johonkanen/agilex3_control_card/reference/bom_draft.csv

ref | value | footprint | lcsc | mpn | dnp
C1 | 10u | Capacitor_SMD:C_0603_1608Metric | C19702 | CL10A106KP8NNNC | False
C2 | 22u | Capacitor_SMD:C_0603_1608Metric | C59461 | CL10A226MQ8NRNC | False
C3 | 22u | Capacitor_SMD:C_0603_1608Metric | C59461 | CL10A226MQ8NRNC | False
C4 | 22p | Capacitor_SMD:C_0402_1005Metric | C1555 | 0402CG220J500NT | False
C5 | 10u | Capacitor_SMD:C_0603_1608Metric | C19702 | CL10A106KP8NNNC | False
C6 | 22u | Capacitor_SMD:C_0603_1608Metric | C59461 | CL10A226MQ8NRNC | False
C7 | 22p | Capacitor_SMD:C_0402_1005Metric | C1555 | 0402CG220J500NT | False
C8 | 10u | Capacitor_SMD:C_0603_1608Metric | C19702 | CL10A106KP8NNNC | False
C9 | 22u | Capacitor_SMD:C_0603_1608Metric | C59461 | CL10A226MQ8NRNC | False
C10 | 1u | Capacitor_SMD:C_0402_1005Metric | C52923 | CL05A105KA5NQNC | False
C11 | 4u7 | Capacitor_SMD:C_0603_1608Metric | C19666 | CL10A475KO8NNNC | False
C12 | 1u | Capacitor_SMD:C_0402_1005Metric | C52923 | CL05A105KA5NQNC | False
C13 | 1u | Capacitor_SMD:C_0402_1005Metric | C52923 | CL05A105KA5NQNC | False
C14 | 22u | Capacitor_SMD:C_0805_2012Metric | C45783 | CL21A226MAQNNNE | False
C15 | 22u | Capacitor_SMD:C_0805_2012Metric | C45783 | CL21A226MAQNNNE | False
C16 | 100n | Capacitor_SMD:C_0402_1005Metric | C1525 | CL05B104KO5NNNC | False
C17 | 22u | Capacitor_SMD:C_0603_1608Metric | C59461 | CL10A226MQ8NRNC | False
C18 | 22u | Capacitor_SMD:C_0603_1608Metric | C59461 | CL10A226MQ8NRNC | False
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
C72 | 1u | Capacitor_SMD:C_0201_0603Metric | C170152 | CL03A105MQ3CSNC | False
C73 | 1u | Capacitor_SMD:C_0201_0603Metric | C170152 | CL03A105MQ3CSNC | False
C74 | 1u | Capacitor_SMD:C_0402_1005Metric | C52923 | CL05A105KA5NQNC | False
C75 | 4u7 | Capacitor_SMD:C_0603_1608Metric | C19666 | CL10A475KO8NNNC | False
C76 | 1u | Capacitor_SMD:C_0201_0603Metric | C170152 | CL03A105MQ3CSNC | False
D1 | RGB | control_card:LED_RGB_APFA3010_RightAngle | C5393554 | APFA3010LSEEZGKQBKC | False
D2 | RGB | control_card:LED_RGB_APFA3010_RightAngle | C5393554 | APFA3010LSEEZGKQBKC | False
FB1 | 120R@100MHz | Inductor_SMD:L_0603_1608Metric | C14709 | BLM18PG121SN1D | False
FB2 | 120R@100MHz | Inductor_SMD:L_0603_1608Metric | C14709 | BLM18PG121SN1D | False
FB3 | 120R@100MHz | Inductor_SMD:L_0603_1608Metric | C14709 | BLM18PG121SN1D | False
FB4 | 120R@100MHz | Inductor_SMD:L_0603_1608Metric | C14709 | BLM18PG121SN1D | False
FB5 | 120R@100MHz | Inductor_SMD:L_0603_1608Metric | C14709 | BLM18PG121SN1D | False
J1 | Power board | control_card:PinHeader_2x25_P1.27mm_Horizontal_U25 |  |  | False
J2 | JTAG | Connector_PinHeader_2.54mm:PinHeader_1x05_P2.54mm_Vertical |  |  | False
L1 | 1u | Inductor_SMD:L_Cenker_CKCS201610 | C97002 | WPN201610H1R0MT | False
L2 | 1u | Inductor_SMD:L_Cenker_CKCS201610 | C97002 | WPN201610H1R0MT | False
L3 | 1u | Inductor_SMD:L_Cenker_CKCS201610 | C97002 | WPN201610H1R0MT | False
R1 | 49k9 | Resistor_SMD:R_0402_1005Metric | C25897 | 0402WGF4992TCE | False
R2 | 200k | Resistor_SMD:R_0402_1005Metric | C25764 | 0402WGF2003TCE | False
R3 | 100R | Resistor_SMD:R_0402_1005Metric | C25076 | 0402WGF1000TCE | False
R4 | 10R | Resistor_SMD:R_0402_1005Metric | C25077 | 0402WGF100JTCE | False
R5 | 100k | Resistor_SMD:R_0402_1005Metric | C25741 | 0402WGF1003TCE | False
R6 | 200k | Resistor_SMD:R_0402_1005Metric | C25764 | 0402WGF2003TCE | False
R7 | 100k | Resistor_SMD:R_0402_1005Metric | C25741 | 0402WGF1003TCE | False
R8 | 100k | Resistor_SMD:R_0402_1005Metric | C25741 | 0402WGF1003TCE | False
R9 | 200k | Resistor_SMD:R_0402_1005Metric | C25764 | 0402WGF2003TCE | False
R10 | 44k2 | Resistor_SMD:R_0402_1005Metric | C25895 | 0402WGF4422TCE | False
R11 | 4k7 | Resistor_SMD:R_0402_1005Metric | C25900 | 0402WGF4701TCE | False
R12 | 4k7 | Resistor_SMD:R_0402_1005Metric | C25900 | 0402WGF4701TCE | False
R13 | 4k7 | Resistor_SMD:R_0402_1005Metric | C25900 | 0402WGF4701TCE | False
R14 | 4k7 | Resistor_SMD:R_0402_1005Metric | C25900 | 0402WGF4701TCE | True
R15 | 10k | Resistor_SMD:R_0402_1005Metric | C25744 | 0402WGF1002TCE | False
R16 | 10k | Resistor_SMD:R_0402_1005Metric | C25744 | 0402WGF1002TCE | False
R17 | 10k | Resistor_SMD:R_0402_1005Metric | C25744 | 0402WGF1002TCE | False
R18 | 10k | Resistor_SMD:R_0402_1005Metric | C25744 | 0402WGF1002TCE | False
R19 | 2k | Resistor_SMD:R_0402_1005Metric | C4109 | 0402WGF2001TCE | False
R20 | 1k | Resistor_SMD:R_0201_0603Metric | C270365 | 0201WMF1001TEE | False
R21 | 10k | Resistor_SMD:R_0201_0603Metric | C473048 | 0201WMF1002TEE | False
R22 | 10k | Resistor_SMD:R_0201_0603Metric | C473048 | 0201WMF1002TEE | False
R23 | 10k | Resistor_SMD:R_0201_0603Metric | C473048 | 0201WMF1002TEE | False
R24 | 10k | Resistor_SMD:R_0402_1005Metric | C25744 | 0402WGF1002TCE | False
R25 | 33R | Resistor_SMD:R_0402_1005Metric | C25105 | 0402WGF330JTCE | False
R26 | 33R | Resistor_SMD:R_0402_1005Metric | C25105 | 0402WGF330JTCE | False
R27 | 33R | Resistor_SMD:R_0402_1005Metric | C25105 | 0402WGF330JTCE | False
R28 | 33R | Resistor_SMD:R_0402_1005Metric | C25105 | 0402WGF330JTCE | False
R29 | 33R | Resistor_SMD:R_0402_1005Metric | C25105 | 0402WGF330JTCE | False
R30 | 33R | Resistor_SMD:R_0402_1005Metric | C25105 | 0402WGF330JTCE | False
R31 | 33R | Resistor_SMD:R_0402_1005Metric | C25105 | 0402WGF330JTCE | False
R32 | 33R | Resistor_SMD:R_0402_1005Metric | C25105 | 0402WGF330JTCE | False
R33 | 33R | Resistor_SMD:R_0402_1005Metric | C25105 | 0402WGF330JTCE | False
R34 | 100R | Resistor_SMD:R_0402_1005Metric | C25076 | 0402WGF1000TCE | False
R35 | 100R | Resistor_SMD:R_0402_1005Metric | C25076 | 0402WGF1000TCE | False
R36 | 100R | Resistor_SMD:R_0402_1005Metric | C25076 | 0402WGF1000TCE | False
R37 | 100R | Resistor_SMD:R_0402_1005Metric | C25076 | 0402WGF1000TCE | False
R38 | 100R | Resistor_SMD:R_0402_1005Metric | C25076 | 0402WGF1000TCE | False
R39 | 100R | Resistor_SMD:R_0402_1005Metric | C25076 | 0402WGF1000TCE | False
U1 | A3CZ065BB18AE7S | control_card:Altera_B18A |  | A3CZ065BB18AE7S | False
U2 | AP61302Z6-7 | Package_TO_SOT_SMD:SOT-563 | C3193204 | AP61302Z6-7 | False
U3 | AP61102Z6-7 | Package_TO_SOT_SMD:SOT-563 | C5224055 | AP61102Z6-7 | False
U4 | AP61102Z6-7 | Package_TO_SOT_SMD:SOT-563 | C5224055 | AP61102Z6-7 | False
U5 | TLV75512PDBVR | Package_TO_SOT_SMD:SOT-23-5 | C2877864 | TLV75512PDBVR | False
U6 | TLV75533PDBVR | Package_TO_SOT_SMD:SOT-23-5 | C404027 | TLV75533PDBVR | False
U7 | MT25QU256ABA8E12-1SIT | control_card:BGA-24_6x8mm_Layout5x5_P1.0mm_CY0.5 | C2061023 | MT25QU256ABA8E12-1SIT | False
U8 | SN74AVC4T774RSVR | Package_DFN_QFN:UQFN-16_1.8x2.6mm_P0.4mm | C779392 | SN74AVC4T774RSVR | False
U9 | W958D8NBYA5I | control_card:BGA-24_6x8mm_Layout5x5_P1.0mm_CY0.5 | C7420405 | W958D8NBYA5I | False
U10 | SN74LV4051APWR | Package_SO:TSSOP-16_4.4x5mm_P0.65mm | C7793 | SN74LV4051APWR | False
U11 | OPA365AIDBVR | Package_TO_SOT_SMD:SOT-23-5 | C96626 | OPA365AIDBVR | False
U12 | ADS7056IRUGR | Package_DFN_QFN:Texas_UQFN-8_1.5x1.5mm_P0.5mm | C2669798 | ADS7056IRUGR | False
U13 | SN74LV4051APWR | Package_SO:TSSOP-16_4.4x5mm_P0.65mm | C7793 | SN74LV4051APWR | False
U14 | OPA365AIDBVR | Package_TO_SOT_SMD:SOT-23-5 | C96626 | OPA365AIDBVR | False
U15 | ADS7056IRUGR | Package_DFN_QFN:Texas_UQFN-8_1.5x1.5mm_P0.5mm | C2669798 | ADS7056IRUGR | False
U16 | TLV75518PDBVR | Package_TO_SOT_SMD:SOT-23-5 | C2877863 | TLV75518PDBVR | False
X1 | 100MHz | Oscillator:Oscillator_SMD_Abracon_ASE-4Pin_3.2x2.5mm | C4353707 | OT3225100MJBA4SL | False
