johonkanen/agilex3_control_card/hardware/control_card.kicad_pcb

## KiCad design hardware/control_card.kicad_pcb (2026-10-28)

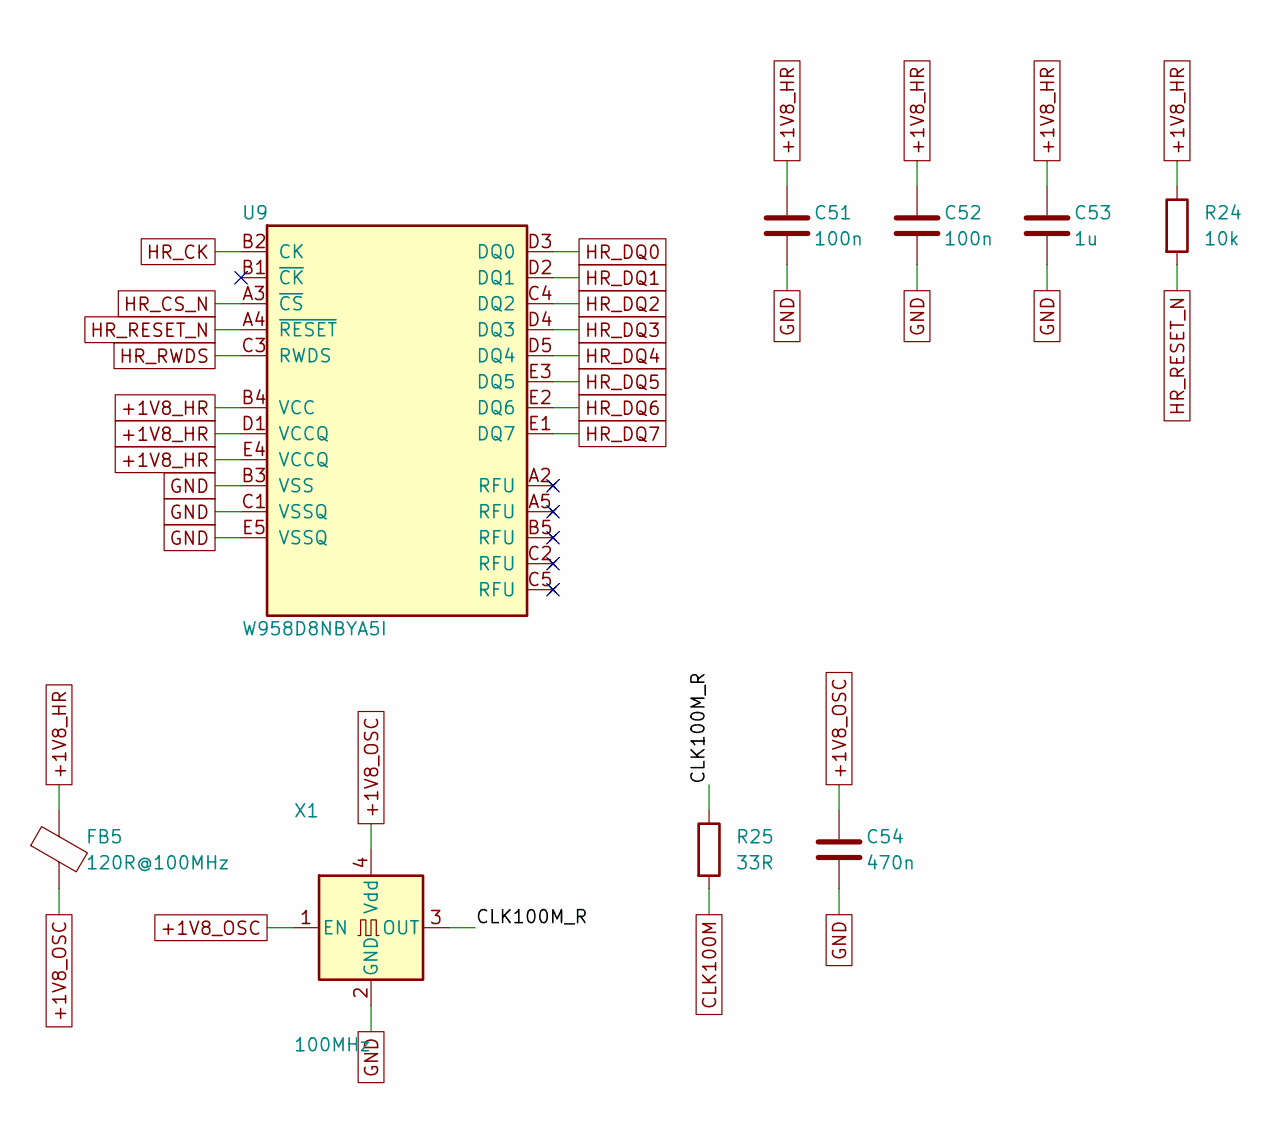
[picture p3: schematic memory.kicad_sch, HyperRAM (1.8 V) and 100 MHz oscillator]

Parts:
C51, C52: 100n; C_0402_1005Metric; MPN CL05B104KO5NNNC; LCSC C1525
C53: 1u; C_0402_1005Metric; MPN CL05A105KA5NQNC; LCSC C52923
C54: 470n; C_0402_1005Metric; MPN CL05A474KP5NNNC; LCSC C47339
FB5: 120R@100MHz; L_0603_1608Metric; MPN BLM18PG121SN1D; LCSC C14709
R24: 10k; R_0402_1005Metric; MPN 0402WGF1002TCE; LCSC C25744
R25: 33R; R_0402_1005Metric; MPN 0402WGF330JTCE; LCSC C25105
U9: W958D8NBYA5I; BGA-24_6x8mm_Layout5x5_P1.0mm_CY0.5; MPN W958D8NBYA5I; LCSC C7420405
X1: 100MHz; Oscillator_SMD_Abracon_ASE-4Pin_3.2x2.5mm; MPN OT3225100MJBA4SL; LCSC C4353707

Connections:
+1V8_HR: C51.1, C52.1, C53.1, FB5.1, R24.1, U9.B4 (VCC), U9.D1 (VCCQ), U9.E4 (VCCQ); also elsewhere on the board
+1V8_OSC: C54.1, FB5.2, X1.1 (EN), X1.4 (Vdd)
/HyperRAM and clock/CLK100M_R: R25.1, X1.3 (OUT)
CLK100M: R25.2; also elsewhere on the board
GND: C51.2, C52.2, C53.2, C54.2, U9.B3 (VSS), U9.C1 (VSSQ), U9.E5 (VSSQ), X1.2 (GND); also elsewhere on the board
HR_CK: U9.B2 (CK); also elsewhere on the board
HR_CS_N: U9.A3 (~CS); also elsewhere on the board
HR_DQ0: U9.D3 (DQ0); also elsewhere on the board
HR_DQ1: U9.D2 (DQ1); also elsewhere on the board
HR_DQ2: U9.C4 (DQ2); also elsewhere on the board
HR_DQ3: U9.D4 (DQ3); also elsewhere on the board
HR_DQ4: U9.D5 (DQ4); also elsewhere on the board
HR_DQ5: U9.E3 (DQ5); also elsewhere on the board
HR_DQ6: U9.E2 (DQ6); also elsewhere on the board
HR_DQ7: U9.E1 (DQ7); also elsewhere on the board
HR_RESET_N: R24.2, U9.A4 (~RESET); also elsewhere on the board
HR_RWDS: U9.C3 (RWDS); also elsewhere on the board

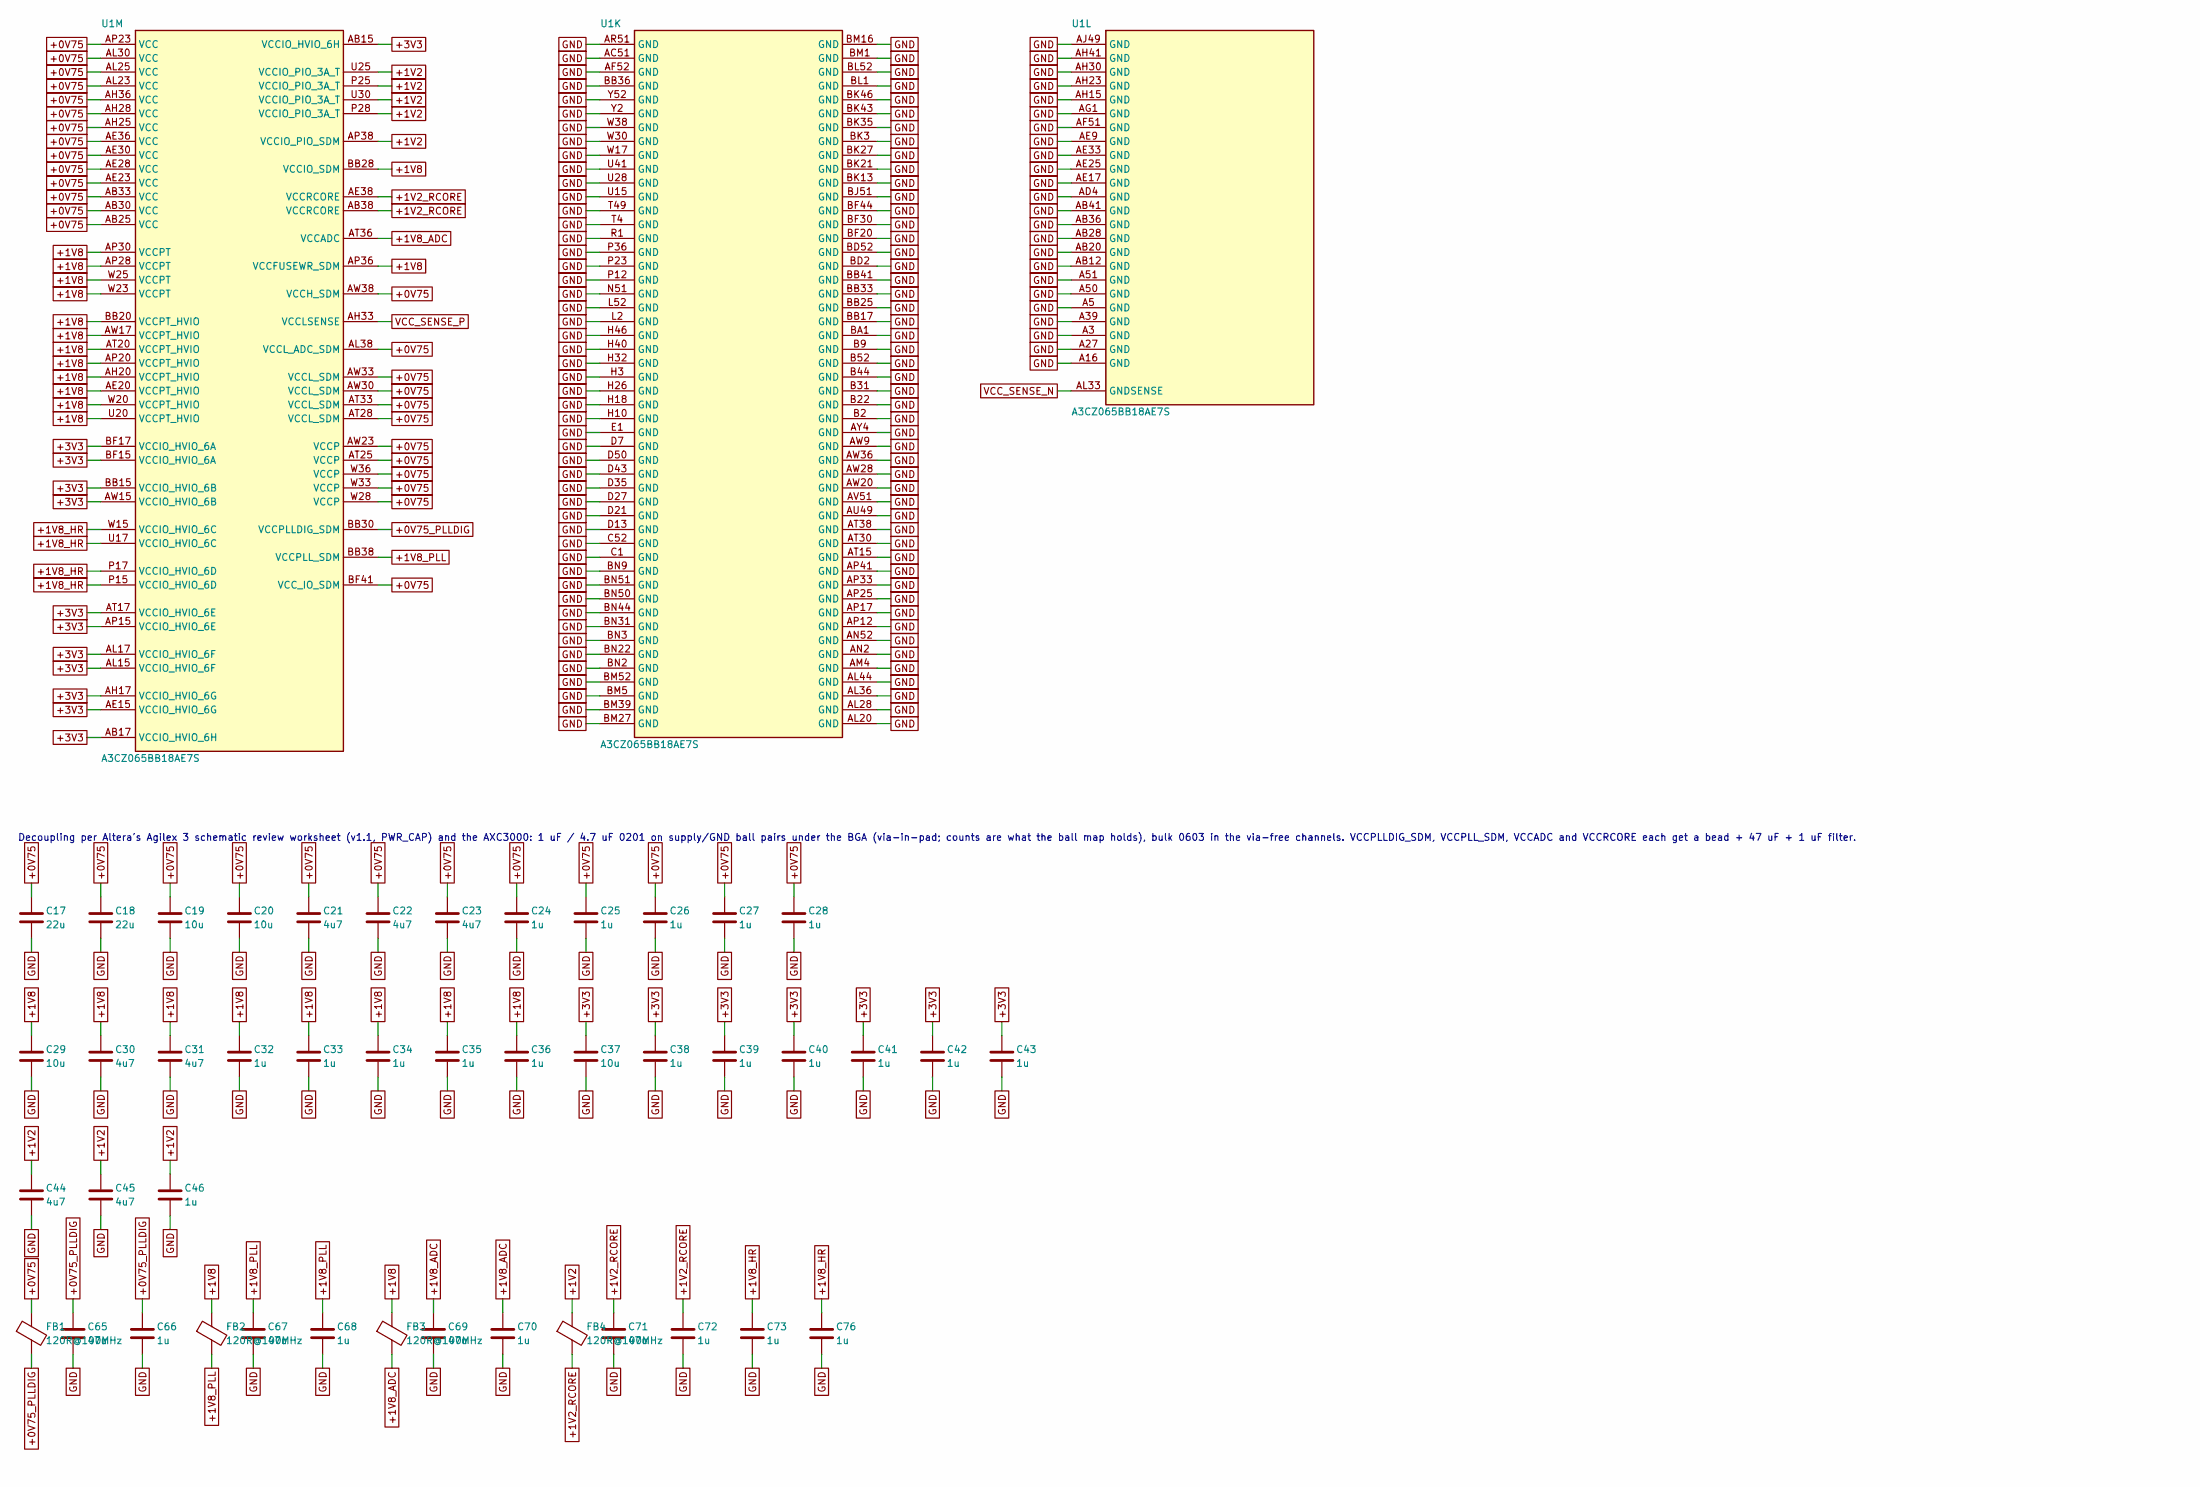
[picture p4: schematic fpga_power.kicad_sch, FPGA supplies, ground and decoupling]

Parts:
C17, C18: 22u; C_0603_1608Metric; MPN CL10A226MQ8NRNC; LCSC C59461
C19, C20, C29, C37: 10u; C_0603_1608Metric; MPN CL10A106KP8NNNC; LCSC C19702
C21, C22, C23, C30, C31, C45: 4u7; C_0201_0603Metric; MPN JDK063BBJ475MV-AT; LCSC C2880368
C24, C25, C26, C27, C28, C32, C33, C34, C35, C36, C38, C39, C40, C41, C42, C43, C46, C66, C68, C70, C72, C73, C76: 1u; C_0201_0603Metric; MPN CL03A105MQ3CSNC; LCSC C170152
C44: 4u7; C_0603_1608Metric; MPN CL10A475KO8NNNC; LCSC C19666
C65, C67, C69, C71: 47u; C_0603_1608Metric; MPN GRM188R60J476ME15D; LCSC C140782
FB1, FB2, FB3, FB4: 120R@100MHz; L_0603_1608Metric; MPN BLM18PG121SN1D; LCSC C14709
U1: A3CZ065BB18AE7S; Altera_B18A; MPN A3CZ065BB18AE7S

Connections:
+0V75: C17.1, C18.1, C19.1, C20.1, C21.1, C22.1, C23.1, C24.1, C25.1, C26.1, C27.1, C28.1, FB1.1, U1.AB25 (VCC), U1.AB30 (VCC), U1.AB33 (VCC), U1.AE23 (VCC), U1.AE28 (VCC), U1.AE30 (VCC), U1.AE36 (VCC), U1.AH25 (VCC), U1.AH28 (VCC), U1.AH36 (VCC), U1.AL23 (VCC), U1.AL25 (VCC), U1.AL30 (VCC), U1.AL38 (VCCL_ADC_SDM), U1.AP23 (VCC), U1.AT25 (VCCP), U1.AT28 (VCCL_SDM), U1.AT33 (VCCL_SDM), U1.AW23 (VCCP), U1.AW30 (VCCL_SDM), U1.AW33 (VCCL_SDM), U1.AW38 (VCCH_SDM), U1.BF41 (VCC_IO_SDM), U1.W28 (VCCP), U1.W33 (VCCP), U1.W36 (VCCP); also elsewhere on the board
+0V75_PLLDIG: C65.1, C66.1, FB1.2, U1.BB30 (VCCPLLDIG_SDM)
+1V2: C44.1, C45.1, C46.1, FB4.1, U1.AP38 (VCCIO_PIO_SDM), U1.P25 (VCCIO_PIO_3A_T), U1.P28 (VCCIO_PIO_3A_T), U1.U25 (VCCIO_PIO_3A_T), U1.U30 (VCCIO_PIO_3A_T); also elsewhere on the board
+1V2_RCORE: C71.1, C72.1, FB4.2, U1.AB38 (VCCRCORE), U1.AE38 (VCCRCORE)
+1V8: C29.1, C30.1, C31.1, C32.1, C33.1, C34.1, C35.1, C36.1, FB2.1, FB3.1, U1.AE20 (VCCPT_HVIO), U1.AH20 (VCCPT_HVIO), U1.AP20 (VCCPT_HVIO), U1.AP28 (VCCPT), U1.AP30 (VCCPT), U1.AP36 (VCCFUSEWR_SDM), U1.AT20 (VCCPT_HVIO), U1.AW17 (VCCPT_HVIO), U1.BB20 (VCCPT_HVIO), U1.BB28 (VCCIO_SDM), U1.U20 (VCCPT_HVIO), U1.W20 (VCCPT_HVIO), U1.W23 (VCCPT), U1.W25 (VCCPT); also elsewhere on the board
+1V8_ADC: C69.1, C70.1, FB3.2, U1.AT36 (VCCADC)
+1V8_HR: C73.1, C76.1, U1.P15 (VCCIO_HVIO_6D), U1.P17 (VCCIO_HVIO_6D), U1.U17 (VCCIO_HVIO_6C), U1.W15 (VCCIO_HVIO_6C); also elsewhere on the board
+1V8_PLL: C67.1, C68.1, FB2.2, U1.BB38 (VCCPLL_SDM)
+3V3: C37.1, C38.1, C39.1, C40.1, C41.1, C42.1, C43.1, U1.AB15 (VCCIO_HVIO_6H), U1.AB17 (VCCIO_HVIO_6H), U1.AE15 (VCCIO_HVIO_6G), U1.AH17 (VCCIO_HVIO_6G), U1.AL15 (VCCIO_HVIO_6F), U1.AL17 (VCCIO_HVIO_6F), U1.AP15 (VCCIO_HVIO_6E), U1.AT17 (VCCIO_HVIO_6E), U1.AW15 (VCCIO_HVIO_6B), U1.BB15 (VCCIO_HVIO_6B), U1.BF15 (VCCIO_HVIO_6A), U1.BF17 (VCCIO_HVIO_6A); also elsewhere on the board
GND: C17.2, C18.2, C19.2, C20.2, C21.2, C22.2, C23.2, C24.2, C25.2, C26.2, C27.2, C28.2, C29.2, C30.2, C31.2, C32.2, C33.2, C34.2, C35.2, C36.2, C37.2, C38.2, C39.2, C40.2, C41.2, C42.2, C43.2, C44.2, C45.2, C46.2, C65.2, C66.2, C67.2, C68.2, C69.2, C70.2, C71.2, C72.2, C73.2, C76.2, U1.A3 (GND), U1.A5 (GND), U1.A16 (GND), U1.A27 (GND), U1.A39 (GND), U1.A50 (GND), U1.A51 (GND), U1.AB12 (GND), U1.AB20 (GND), U1.AB28 (GND), U1.AB36 (GND), U1.AB41 (GND), U1.AC51 (GND), U1.AD4 (GND), U1.AE9 (GND), U1.AE17 (GND), U1.AE25 (GND), U1.AE33 (GND), U1.AF51 (GND), U1.AF52 (GND), U1.AG1 (GND), U1.AH15 (GND), U1.AH23 (GND), U1.AH30 (GND), U1.AH41 (GND), U1.AJ49 (GND), U1.AL20 (GND), U1.AL28 (GND), U1.AL36 (GND), U1.AL44 (GND), U1.AM4 (GND), U1.AN2 (GND), U1.AN52 (GND), U1.AP12 (GND), U1.AP17 (GND), U1.AP25 (GND), U1.AP33 (GND), U1.AP41 (GND), U1.AR51 (GND), U1.AT15 (GND), U1.AT30 (GND), U1.AT38 (GND), U1.AU49 (GND), U1.AV51 (GND), U1.AW9 (GND), U1.AW20 (GND), U1.AW28 (GND), U1.AW36 (GND), U1.AY4 (GND), U1.B2 (GND), U1.B9 (GND), U1.B22 (GND), U1.B31 (GND), U1.B44 (GND), U1.B52 (GND), U1.BA1 (GND), U1.BB17 (GND), U1.BB25 (GND), U1.BB33 (GND), U1.BB36 (GND), U1.BB41 (GND), U1.BD2 (GND), U1.BD52 (GND), U1.BF20 (GND), U1.BF30 (GND), U1.BF44 (GND), U1.BJ51 (GND), U1.BK3 (GND), U1.BK13 (GND), U1.BK21 (GND), U1.BK27 (GND), U1.BK35 (GND), U1.BK43 (GND), U1.BK46 (GND), U1.BL1 (GND), U1.BL52 (GND), U1.BM1 (GND), U1.BM5 (GND), U1.BM16 (GND), U1.BM27 (GND), U1.BM39 (GND), U1.BM52 (GND), U1.BN2 (GND), U1.BN3 (GND), U1.BN9 (GND), U1.BN22 (GND), U1.BN31 (GND), U1.BN44 (GND), U1.BN50 (GND), U1.BN51 (GND), U1.C1 (GND), U1.C52 (GND), U1.D7 (GND), U1.D13 (GND), U1.D21 (GND), U1.D27 (GND), U1.D35 (GND), U1.D43 (GND), U1.D50 (GND), U1.E1 (GND), U1.H3 (GND), U1.H10 (GND), U1.H18 (GND), U1.H26 (GND), U1.H32 (GND), U1.H40 (GND), U1.H46 (GND), U1.L2 (GND), U1.L52 (GND), U1.N51 (GND), U1.P12 (GND), U1.P23 (GND), U1.P36 (GND), U1.R1 (GND), U1.T4 (GND), U1.T49 (GND), U1.U15 (GND), U1.U28 (GND), U1.U41 (GND), U1.W17 (GND), U1.W30 (GND), U1.W38 (GND), U1.Y2 (GND), U1.Y52 (GND); also elsewhere on the board
VCC_SENSE_N: U1.AL33 (GNDSENSE); also elsewhere on the board
VCC_SENSE_P: U1.AH33 (VCCLSENSE); also elsewhere on the board

Notes on the sheet:
Decoupling per Altera's Agilex 3 schematic review worksheet (v1.1, PWR_CAP) and the AXC3000: 1 uF / 4.7 uF 0201 on supply/GND ball pairs under the BGA (via-in-pad; counts are what the ball map holds), bulk 0603 in the via-free channels. VCCPLLDIG_SDM, VCCPLL_SDM, VCCADC and VCCRCORE each get a bead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

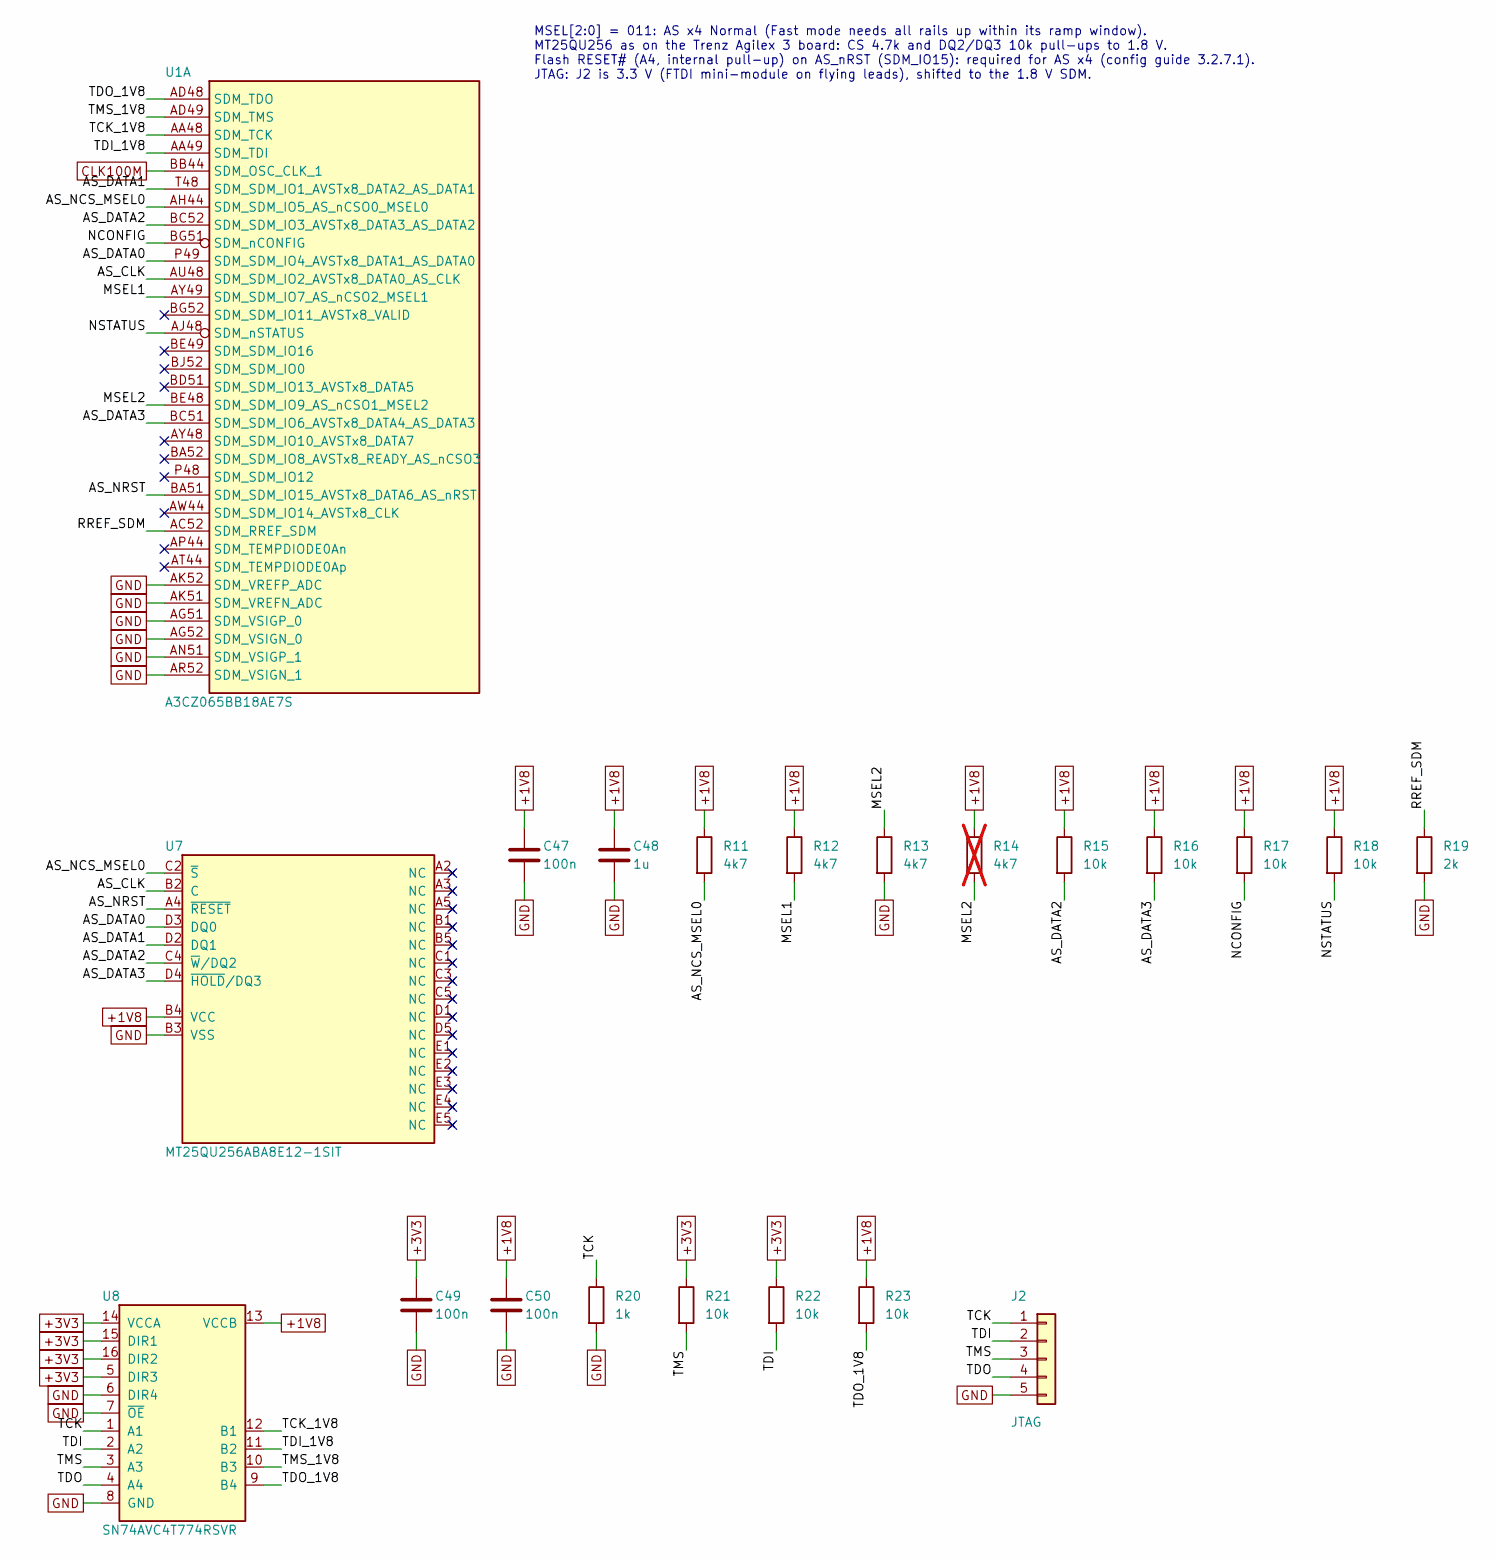
[picture p5: schematic config.kicad_sch, SDM: AS x4 flash, MSEL, JTAG]

Parts:
C47: 100n; C_0402_1005Metric; MPN CL05B104KO5NNNC; LCSC C1525
C48: 1u; C_0402_1005Metric; MPN CL05A105KA5NQNC; LCSC C52923
C49, C50: 100n; C_0201_0603Metric; MPN CL03A104KP3NNNC; LCSC C49062
J2: JTAG; PinHeader_1x05_P2.54mm_Vertical
R11, R12, R13: 4k7; R_0402_1005Metric; MPN 0402WGF4701TCE; LCSC C25900
R14: 4k7; R_0402_1005Metric; MPN 0402WGF4701TCE; LCSC C25900; not fitted
R15, R16, R17, R18: 10k; R_0402_1005Metric; MPN 0402WGF1002TCE; LCSC C25744
R19: 2k; R_0402_1005Metric; MPN 0402WGF2001TCE; LCSC C4109
R20: 1k; R_0201_0603Metric; MPN 0201WMF1001TEE; LCSC C270365
R21, R22, R23: 10k; R_0201_0603Metric; MPN 0201WMF1002TEE; LCSC C473048
U1: A3CZ065BB18AE7S; Altera_B18A; MPN A3CZ065BB18AE7S
U7: MT25QU256ABA8E12-1SIT; BGA-24_6x8mm_Layout5x5_P1.0mm_CY0.5; MPN MT25QU256ABA8E12-1SIT; LCSC C2061023
U8: SN74AVC4T774RSVR; UQFN-16_1.8x2.6mm_P0.4mm; MPN SN74AVC4T774RSVR; LCSC C779392

Connections:
+1V8: C47.1, C48.1, C50.1, R11.1, R12.1, R14.1, R15.1, R16.1, R17.1, R18.1, R23.1, U7.B4 (VCC), U8.13 (VCCB); also elsewhere on the board
+3V3: C49.1, R21.1, R22.1, U8.5 (DIR3), U8.14 (VCCA), U8.15 (DIR1), U8.16 (DIR2); also elsewhere on the board
/Configuration/AS_CLK: U1.AU48 (SDM_SDM_IO2_AVSTx8_DATA0_AS_CLK), U7.B2 (C)
/Configuration/AS_DATA0: U1.P49 (SDM_SDM_IO4_AVSTx8_DATA1_AS_DATA0), U7.D3 (DQ0)
/Configuration/AS_DATA1: U1.T48 (SDM_SDM_IO1_AVSTx8_DATA2_AS_DATA1), U7.D2 (DQ1)
/Configuration/AS_DATA2: R15.2, U1.BC52 (SDM_SDM_IO3_AVSTx8_DATA3_AS_DATA2), U7.C4 (~W/DQ2)
/Configuration/AS_DATA3: R16.2, U1.BC51 (SDM_SDM_IO6_AVSTx8_DATA4_AS_DATA3), U7.D4 (~HOLD/DQ3)
/Configuration/AS_NCS_MSEL0: R11.2, U1.AH44 (SDM_SDM_IO5_AS_nCSO0_MSEL0), U7.C2 (~S)
/Configuration/AS_NRST: U1.BA51 (SDM_SDM_IO15_AVSTx8_DATA6_AS_nRST), U7.A4 (~RESET)
/Configuration/MSEL1: R12.2, U1.AY49 (SDM_SDM_IO7_AS_nCSO2_MSEL1)
/Configuration/MSEL2: R13.1, R14.2, U1.BE48 (SDM_SDM_IO9_AS_nCSO1_MSEL2)
/Configuration/NCONFIG: R17.2, U1.BG51 (SDM_nCONFIG)
/Configuration/NSTATUS: R18.2, U1.AJ48 (SDM_nSTATUS)
/Configuration/RREF_SDM: R19.1, U1.AC52 (SDM_RREF_SDM)
/Configuration/TCK: J2.1, R20.1, U8.1 (A1)
/Configuration/TCK_1V8: U1.AA48 (SDM_TCK), U8.12 (B1)
/Configuration/TDI: J2.2, R22.2, U8.2 (A2)
/Configuration/TDI_1V8: U1.AA49 (SDM_TDI), U8.11 (B2)
/Configuration/TDO: J2.4, U8.4 (A4)
/Configuration/TDO_1V8: R23.2, U1.AD48 (SDM_TDO), U8.9 (B4)
/Configuration/TMS: J2.3, R21.2, U8.3 (A3)
/Configuration/TMS_1V8: U1.AD49 (SDM_TMS), U8.10 (B3)
CLK100M: U1.BB44 (SDM_OSC_CLK_1); also elsewhere on the board
GND: C47.2, C48.2, C49.2, C50.2, J2.5, R13.2, R19.2, R20.2, U1.AG51 (SDM_VSIGP_0), U1.AG52 (SDM_VSIGN_0), U1.AK51 (SDM_VREFN_ADC), U1.AK52 (SDM_VREFP_ADC), U1.AN51 (SDM_VSIGP_1), U1.AR52 (SDM_VSIGN_1), U7.B3 (VSS), U8.6 (DIR4), U8.7 (~OE), U8.8 (GND); also elsewhere on the board

Notes on the sheet:
MSEL[2:0] = 011: AS x4 Normal (Fast mode needs all rails up within its ramp window). MT25QU256 as on the Trenz Agilex 3 board: CS 4.7k and DQ2/DQ3 10k pull-ups to 1.8 V. Flash RESET# (A4, internal pull-up) on AS_nRST (SDM_IO15): required for AS x4 (config guide 3.2.7.1). JTAG: J2 is 3.3 V (FTDI min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

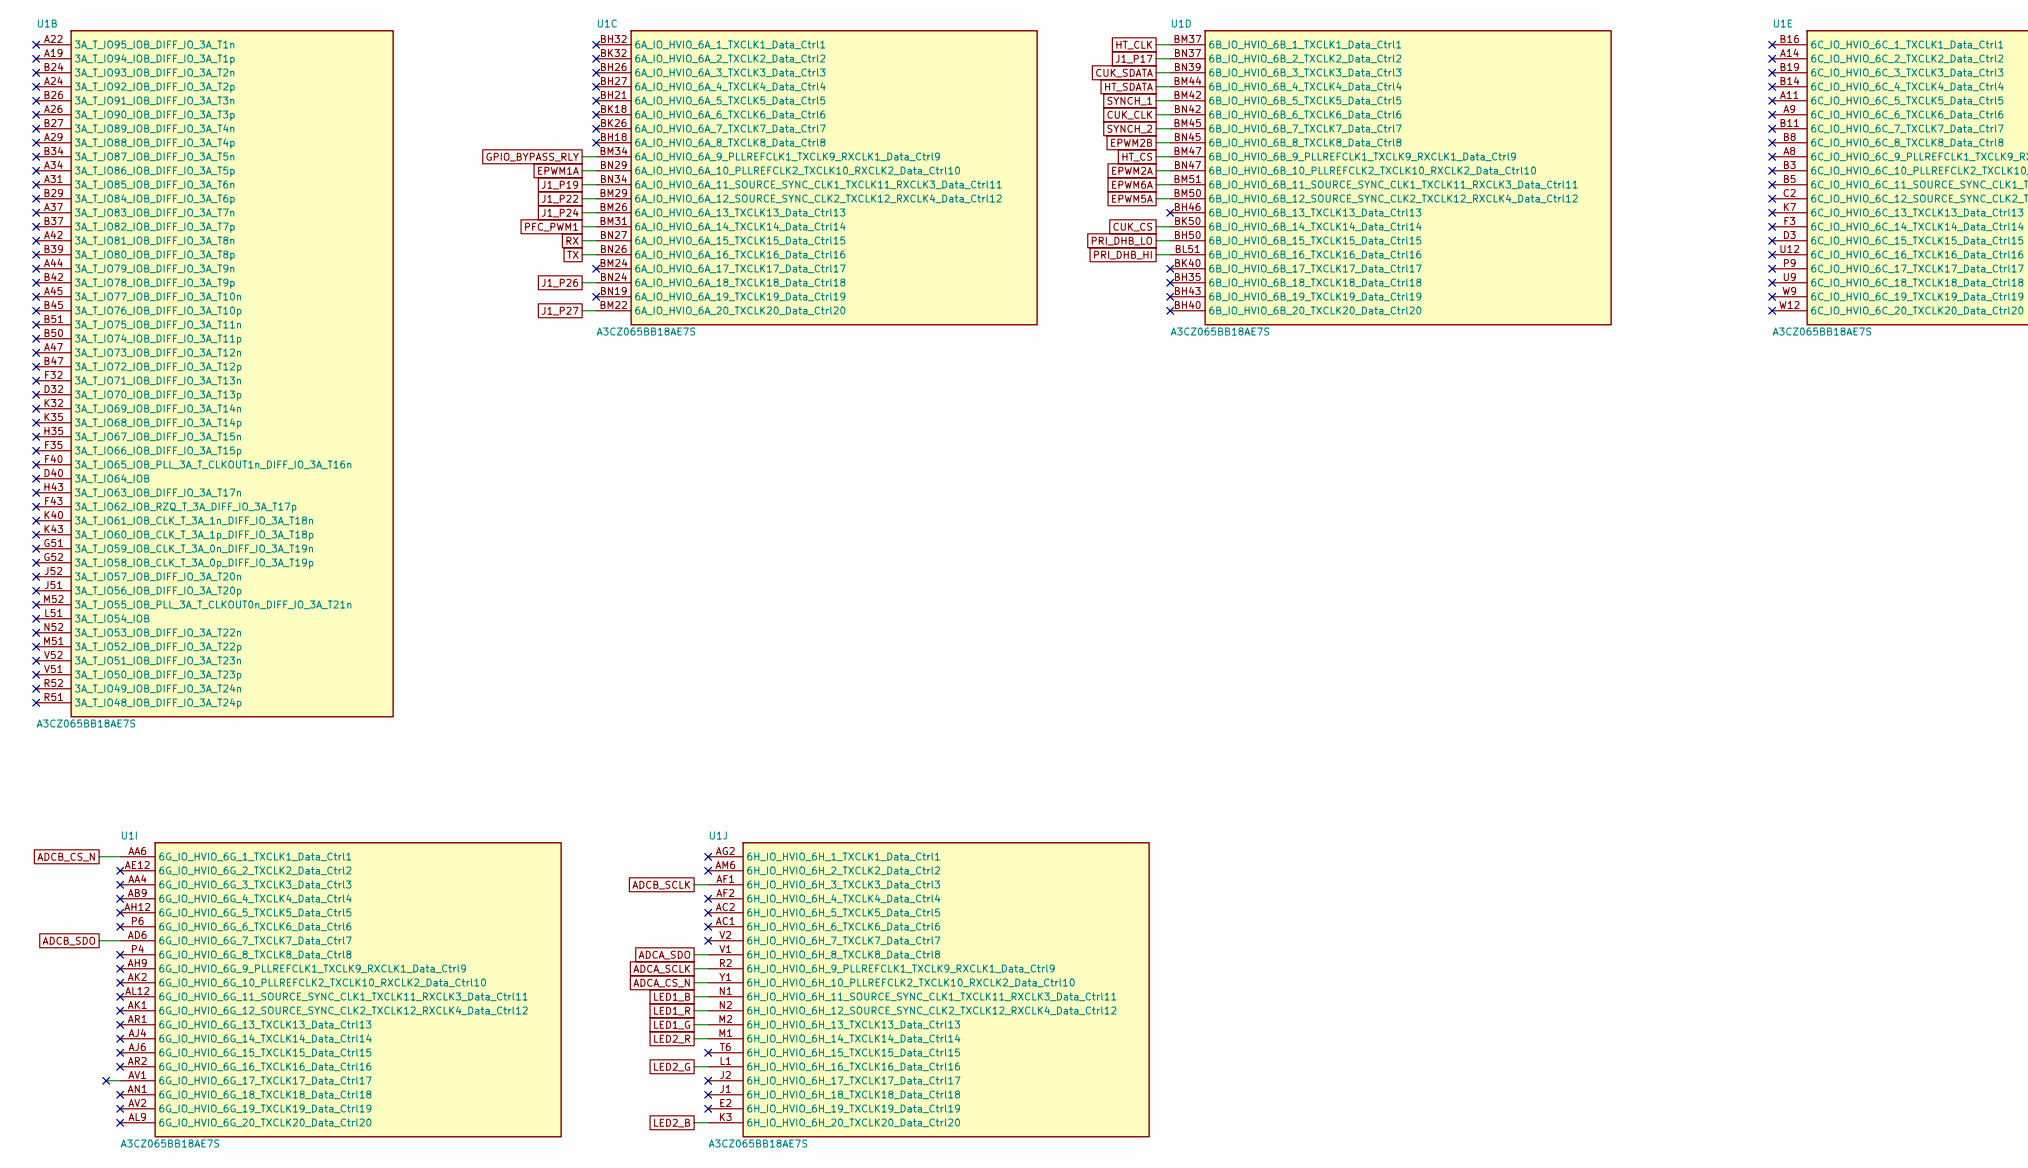
[picture p6: schematic fpga_io.kicad_sch, FPGA I/O banks (pin assignment: reference/pin_assignment.cs…, part in row 1, column 1]

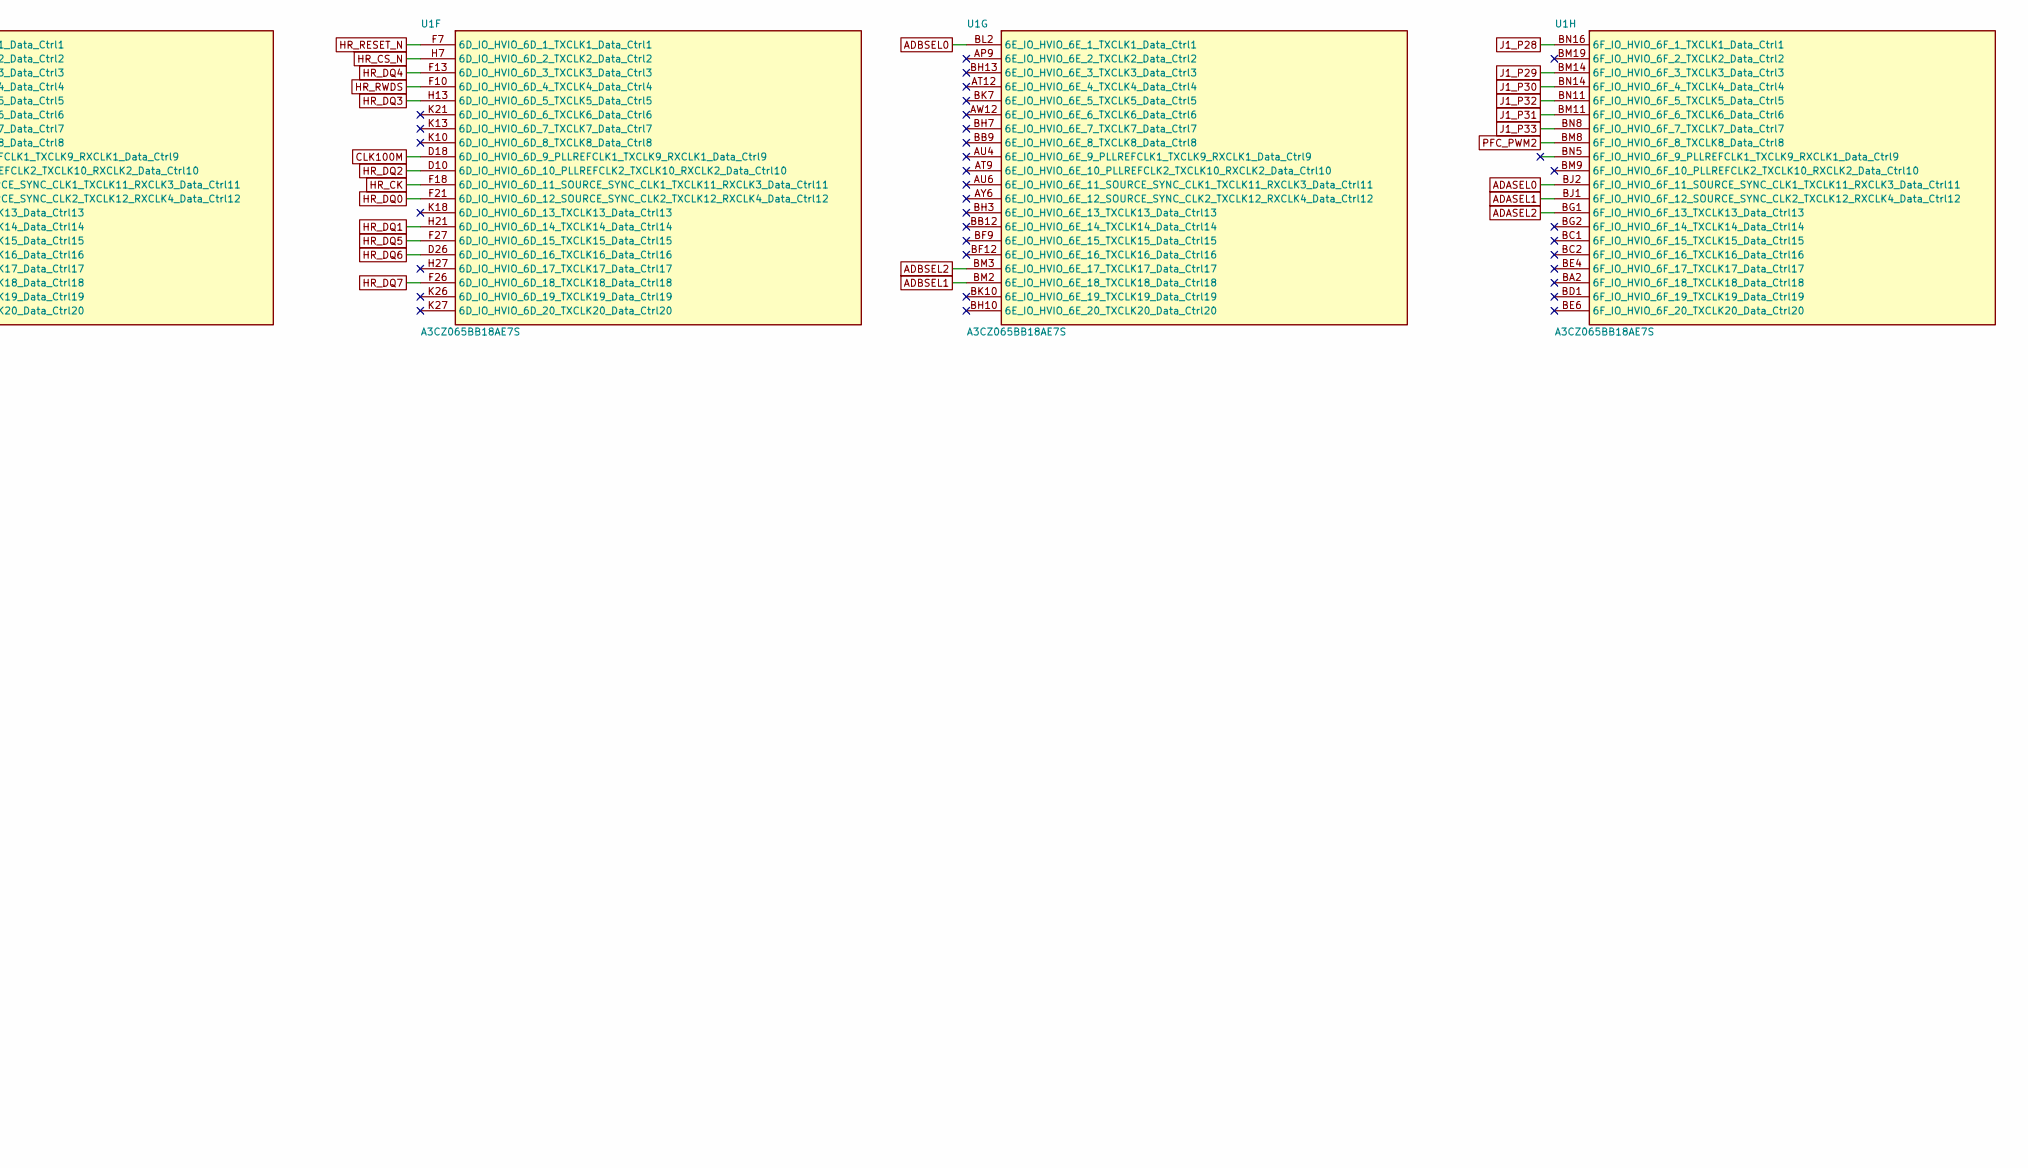
[picture p7: schematic fpga_io.kicad_sch, FPGA I/O banks (pin assignment: reference/pin_assignment.cs…, part in row 1, column 2]

Parts:
U1: A3CZ065BB18AE7S; Altera_B18A; MPN A3CZ065BB18AE7S

Connections:
ADASEL0: U1.BJ2 (6F_IO_HVIO_6F_11_SOURCE_SYNC_CLK1_TXCLK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); also elsewhere on the board
ADASEL1: U1.BJ1 (6F_IO_HVIO_6F_12_SOURCE_SYNC_CLK2_TXCLK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); also elsewhere on the board
ADASEL2: U1.BG1 (6F_IO_HVIO_6F_13_TXCLK13_Data_Ctrl13); also elsewhere on the board
ADBSEL0: U1.BL2 (6E_IO_HVIO_6E_1_TXCLK1_Data_Ctrl1); also elsewhere on the board
ADBSEL1: U1.BM2 (6E_IO_HVIO_6E_18_TXCLK18_Data_Ctrl18); also elsewhere on the board
ADBSEL2: U1.BM3 (6E_IO_HVIO_6E_17_TXCLK17_Data_Ctrl17); also elsewhere on the board
ADCA_CS_N: U1.Y1 (6H_IO_HVIO_6H_10_PLLREFCLK2_TXCLK10_RXC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); also elsewhere on the board
ADCA_SCLK: U1.R2 (6H_IO_HVIO_6H_9_PLLREFCLK1_TXCLK9_RXCLK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); also elsewhere on the board
ADCA_SDO: U1.V1 (6H_IO_HVIO_6H_8_TXCLK8_Data_Ctrl8); also elsewhere on the board
ADCB_CS_N: U1.AA6 (6G_IO_HVIO_6G_1_TXCLK1_Data_Ctrl1); also elsewhere on the board
ADCB_SCLK: U1.AF1 (6H_IO_HVIO_6H_3_TXCLK3_Data_Ctrl3); also elsewhere on the board
ADCB_SDO: U1.AD6 (6G_IO_HVIO_6G_7_TXCLK7_Data_Ctrl7); also elsewhere on the board
CLK100M: U1.D18 (6D_IO_HVIO_6D_9_PLLREFCLK1_TXCLK9_RXCLK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); also elsewhere on the board
CUK_CLK: U1.BN42 (6B_IO_HVIO_6B_6_TXCLK6_Data_Ctrl6); also elsewhere on the board
CUK_CS: U1.BK50 (6B_IO_HVIO_6B_14_TXCLK14_Data_Ctrl14); also elsewhere on the board
CUK_SDATA: U1.BN39 (6B_IO_HVIO_6B_3_TXCLK3_Data_Ctrl3); also elsewhere on the board
EPWM1A: U1.BN29 (6A_IO_HVIO_6A_10_PLLREFCLK2_TXCLK10_RXC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); also elsewhere on the board
EPWM2A: U1.BN47 (6B_IO_HVIO_6B_10_PLLREFCLK2_TXCLK10_RXC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); also elsewhere on the board
EPWM2B: U1.BN45 (6B_IO_HVIO_6B_8_TXCLK8_Data_Ctrl8); also elsewhere on the board
EPWM5A: U1.BM50 (6B_IO_HVIO_6B_12_SOURCE_SYNC_CLK2_TXCLK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); also elsewhere on the board
EPWM6A: U1.BM51 (6B_IO_HVIO_6B_11_SOURCE_SYNC_CLK1_TXCLK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); also elsewhere on the board
GPIO_BYPASS_RLY: U1.BM34 (6A_IO_HVIO_6A_9_PLLREFCLK1_TXCLK9_RXCLK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); also elsewhere on the board
HR_CK: U1.F18 (6D_IO_HVIO_6D_11_SOURCE_SYNC_CLK1_TXCLK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); also elsewhere on the board
HR_CS_N: U1.H7 (6D_IO_HVIO_6D_2_TXCLK2_Data_Ctrl2); also elsewhere on the board
HR_DQ0: U1.F21 (6D_IO_HVIO_6D_12_SOURCE_SYNC_CLK2_TXCLK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); also elsewhere on the board
HR_DQ1: U1.H21 (6D_IO_HVIO_6D_14_TXCLK14_Data_Ctrl14); also elsewhere on the board
HR_DQ2: U1.D10 (6D_IO_HVIO_6D_10_PLLREFCLK2_TXCLK10_RXC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); also elsewhere on the board
HR_DQ3: U1.H13 (6D_IO_HVIO_6D_5_TXCLK5_Data_Ctrl5); also elsewhere on the board
HR_DQ4: U1.F13 (6D_IO_HVIO_6D_3_TXCLK3_Data_Ctrl3); also elsewhere on the board
HR_DQ5: U1.F27 (6D_IO_HVIO_6D_15_TXCLK15_Data_Ctrl15); also elsewhere on the board
HR_DQ6: U1.D26 (6D_IO_HVIO_6D_16_TXCLK16_Data_Ctrl16); also elsewhere on the board
HR_DQ7: U1.F26 (6D_IO_HVIO_6D_18_TXCLK18_Data_Ctrl18); also elsewhere on the board
HR_RESET_N: U1.F7 (6D_IO_HVIO_6D_1_TXCLK1_Data_Ctrl1); also elsewhere on the board
HR_RWDS: U1.F10 (6D_IO_HVIO_6D_4_TXCLK4_Data_Ctrl4); also elsewhere on the board
HT_CLK: U1.BM37 (6B_IO_HVIO_6B_1_TXCLK1_Data_Ctrl1); also elsewhere on the board
HT_CS: U1.BM47 (6B_IO_HVIO_6B_9_PLLREFCLK1_TXCLK9_RXCLK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); also elsewhere on the board
HT_SDATA: U1.BM44 (6B_IO_HVIO_6B_4_TXCLK4_Data_Ctrl4); also elsewhere on the board
J1_P17: U1.BN37 (6B_IO_HVIO_6B_2_TXCLK2_Data_Ctrl2); also elsewhere on the board
J1_P19: U1.BN34 (6A_IO_HVIO_6A_11_SOURCE_SYNC_CLK1_TXCLK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); also elsewhere on the board
J1_P22: U1.BM29 (6A_IO_HVIO_6A_12_SOURCE_SYNC_CLK2_TXCLK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); also elsewhere on the board
J1_P24: U1.BM26 (6A_IO_HVIO_6A_13_TXCLK13_Data_Ctrl13); also elsewhere on the board
J1_P26: U1.BN24 (6A_IO_HVIO_6A_18_TXCLK18_Data_Ctrl18); also elsewhere on the board
J1_P27: U1.BM22 (6A_IO_HVIO_6A_20_TXCLK20_Data_Ctrl20); also elsewhere on the board
J1_P28: U1.BN16 (6F_IO_HVIO_6F_1_TXCLK1_Data_Ctrl1); also elsewhere on the board
J1_P29: U1.BM14 (6F_IO_HVIO_6F_3_TXCLK3_Data_Ctrl3); also elsewhere on the board
J1_P30: U1.BN14 (6F_IO_HVIO_6F_4_TXCLK4_Data_Ctrl4); also elsewhere on the board
J1_P31: U1.BM11 (6F_IO_HVIO_6F_6_TXCLK6_Data_Ctrl6); also elsewhere on the board
J1_P32: U1.BN11 (6F_IO_HVIO_6F_5_TXCLK5_Data_Ctrl5); also elsewhere on the board
J1_P33: U1.BN8 (6F_IO_HVIO_6F_7_TXCLK7_Data_Ctrl7); also elsewhere on the board
LED1_B: U1.N1 (6H_IO_HVIO_6H_11_SOURCE_SYNC_CLK1_TXCLK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); also elsewhere on the board
LED1_G: U1.M2 (6H_IO_HVIO_6H_13_TXCLK13_Data_Ctrl13); also elsewhere on the board
LED1_R: U1.N2 (6H_IO_HVIO_6H_12_SOURCE_SYNC_CLK2_TXCLK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); also elsewhere on the board
LED2_B: U1.K3 (6H_IO_HVIO_6H_20_TXCLK20_Data_Ctrl20); also elsewhere on the board
LED2_G: U1.L1 (6H_IO_HVIO_6H_16_TXCLK16_Data_Ctrl16); also elsewhere on the board
LED2_R: U1.M1 (6H_IO_HVIO_6H_14_TXCLK14_Data_Ctrl14); also elsewhere on the board
PFC_PWM1: U1.BM31 (6A_IO_HVIO_6A_14_TXCLK14_Data_Ctrl14); also elsewhere on the board
PFC_PWM2: U1.BM8 (6F_IO_HVIO_6F_8_TXCLK8_Data_Ctrl8); also elsewhere on the board
PRI_DHB_HI: U1.BL51 (6B_IO_HVIO_6B_16_TXCLK16_Data_Ctrl16); also elsewhere on the board
PRI_DHB_LO: U1.BH50 (6B_IO_HVIO_6B_15_TXCLK15_Data_Ctrl15); also elsewhere on the board
RX: U1.BN27 (6A_IO_HVIO_6A_15_TXCLK15_Data_Ctrl15); also elsewhere on the board
SYNCH_1: U1.BM42 (6B_IO_HVIO_6B_5_TXCLK5_Data_Ctrl5); also elsewhere on the board
SYNCH_2: U1.BM45 (6B_IO_HVIO_6B_7_TXCLK7_Data_Ctrl7); also elsewhere on the board
TX: U1.BN26 (6A_IO_HVIO_6A_16_TXCLK16_Data_Ctrl16); also elsewhere on the board
