johonkanen/agilex3_control_card/hardware/control_card.kicad_pcb

## KiCad design hardware/control_card.kicad_pcb (continued)

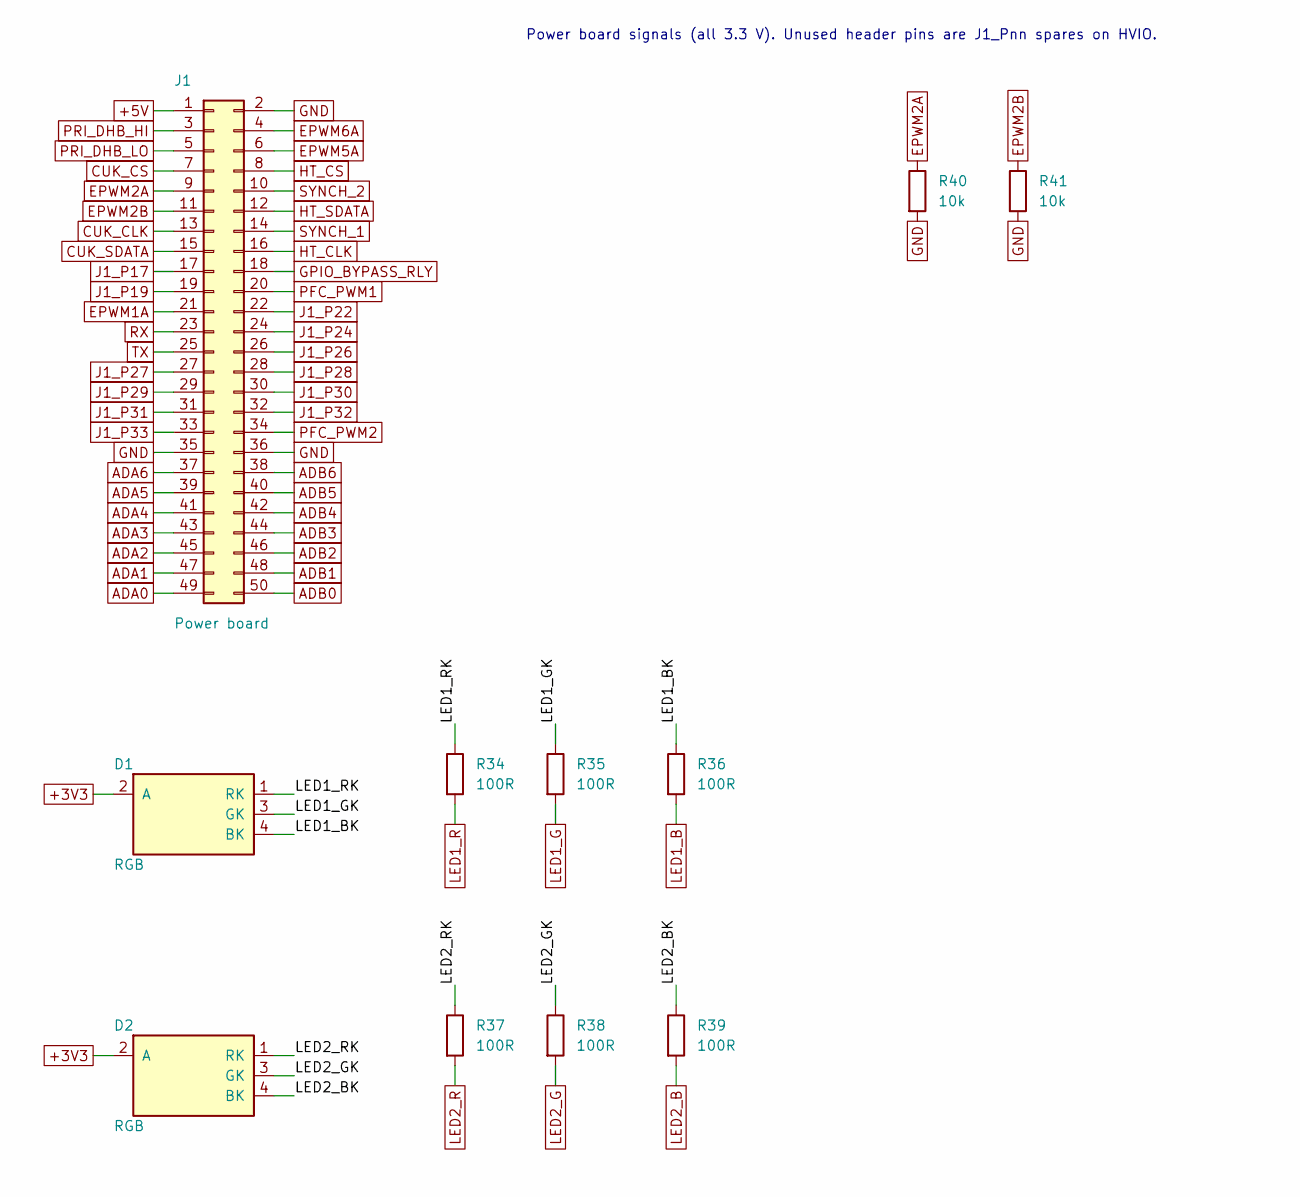
[picture p8: schematic connector.kicad_sch, J1 to the power board, RGB LEDs]

Parts:
D1, D2: RGB; LED_RGB_APFA3010_RightAngle; MPN APFA3010LSEEZGKQBKC; LCSC C5393554
J1: Power board; PinHeader_2x25_P1.27mm_Horizontal_U25
R34, R35, R36, R37, R38, R39: 100R; R_0402_1005Metric; MPN 0402WGF1000TCE; LCSC C25076
R40, R41: 10k; R_0201_0603Metric; MPN 0201WMF1002TEE; LCSC C473048

Connections:
+3V3: D1.2 (A), D2.2 (A); also elsewhere on the board
+5V: J1.1; also elsewhere on the board
/Header and LEDs/LED1_BK: D1.4 (BK), R36.1
/Header and LEDs/LED1_GK: D1.3 (GK), R35.1
/Header and LEDs/LED1_RK: D1.1 (RK), R34.1
/Header and LEDs/LED2_BK: D2.4 (BK), R39.1
/Header and LEDs/LED2_GK: D2.3 (GK), R38.1
/Header and LEDs/LED2_RK: D2.1 (RK), R37.1
ADA0: J1.49; also elsewhere on the board
ADA1: J1.47; also elsewhere on the board
ADA2: J1.45; also elsewhere on the board
ADA3: J1.43; also elsewhere on the board
ADA4: J1.41; also elsewhere on the board
ADA5: J1.39; also elsewhere on the board
ADA6: J1.37; also elsewhere on the board
ADB0: J1.50; also elsewhere on the board
ADB1: J1.48; also elsewhere on the board
ADB2: J1.46; also elsewhere on the board
ADB3: J1.44; also elsewhere on the board
ADB4: J1.42; also elsewhere on the board
ADB5: J1.40; also elsewhere on the board
ADB6: J1.38; also elsewhere on the board
CUK_CLK: J1.13; also elsewhere on the board
CUK_CS: J1.7; also elsewhere on the board
CUK_SDATA: J1.15; also elsewhere on the board
EPWM1A: J1.21; also elsewhere on the board
EPWM2A: J1.9, R40.1; also elsewhere on the board
EPWM2B: J1.11, R41.1; also elsewhere on the board
EPWM5A: J1.6; also elsewhere on the board
EPWM6A: J1.4; also elsewhere on the board
GND: J1.2, J1.35, J1.36, R40.2, R41.2; also elsewhere on the board
GPIO_BYPASS_RLY: J1.18; also elsewhere on the board
HT_CLK: J1.16; also elsewhere on the board
HT_CS: J1.8; also elsewhere on the board
HT_SDATA: J1.12; also elsewhere on the board
J1_P17: J1.17; also elsewhere on the board
J1_P19: J1.19; also elsewhere on the board
J1_P22: J1.22; also elsewhere on the board
J1_P24: J1.24; also elsewhere on the board
J1_P26: J1.26; also elsewhere on the board
J1_P27: J1.27; also elsewhere on the board
J1_P28: J1.28; also elsewhere on the board
J1_P29: J1.29; also elsewhere on the board
J1_P30: J1.30; also elsewhere on the board
J1_P31: J1.31; also elsewhere on the board
J1_P32: J1.32; also elsewhere on the board
J1_P33: J1.33; also elsewhere on the board
LED1_B: R36.2; also elsewhere on the board
LED1_G: R35.2; also elsewhere on the board
LED1_R: R34.2; also elsewhere on the board
LED2_B: R39.2; also elsewhere on the board
LED2_G: R38.2; also elsewhere on the board
LED2_R: R37.2; also elsewhere on the board
PFC_PWM1: J1.20; also elsewhere on the board
PFC_PWM2: J1.34; also elsewhere on the board
PRI_DHB_HI: J1.3; also elsewhere on the board
PRI_DHB_LO: J1.5; also elsewhere on the board
RX: J1.23; also elsewhere on the board
SYNCH_1: J1.14; also elsewhere on the board
SYNCH_2: J1.10; also elsewhere on the board
TX: J1.25; also elsewhere on the board

Notes on the sheet:
Power board signals (all 3.3 V). Unused header pins are J1_Pnn spares on HVIO.

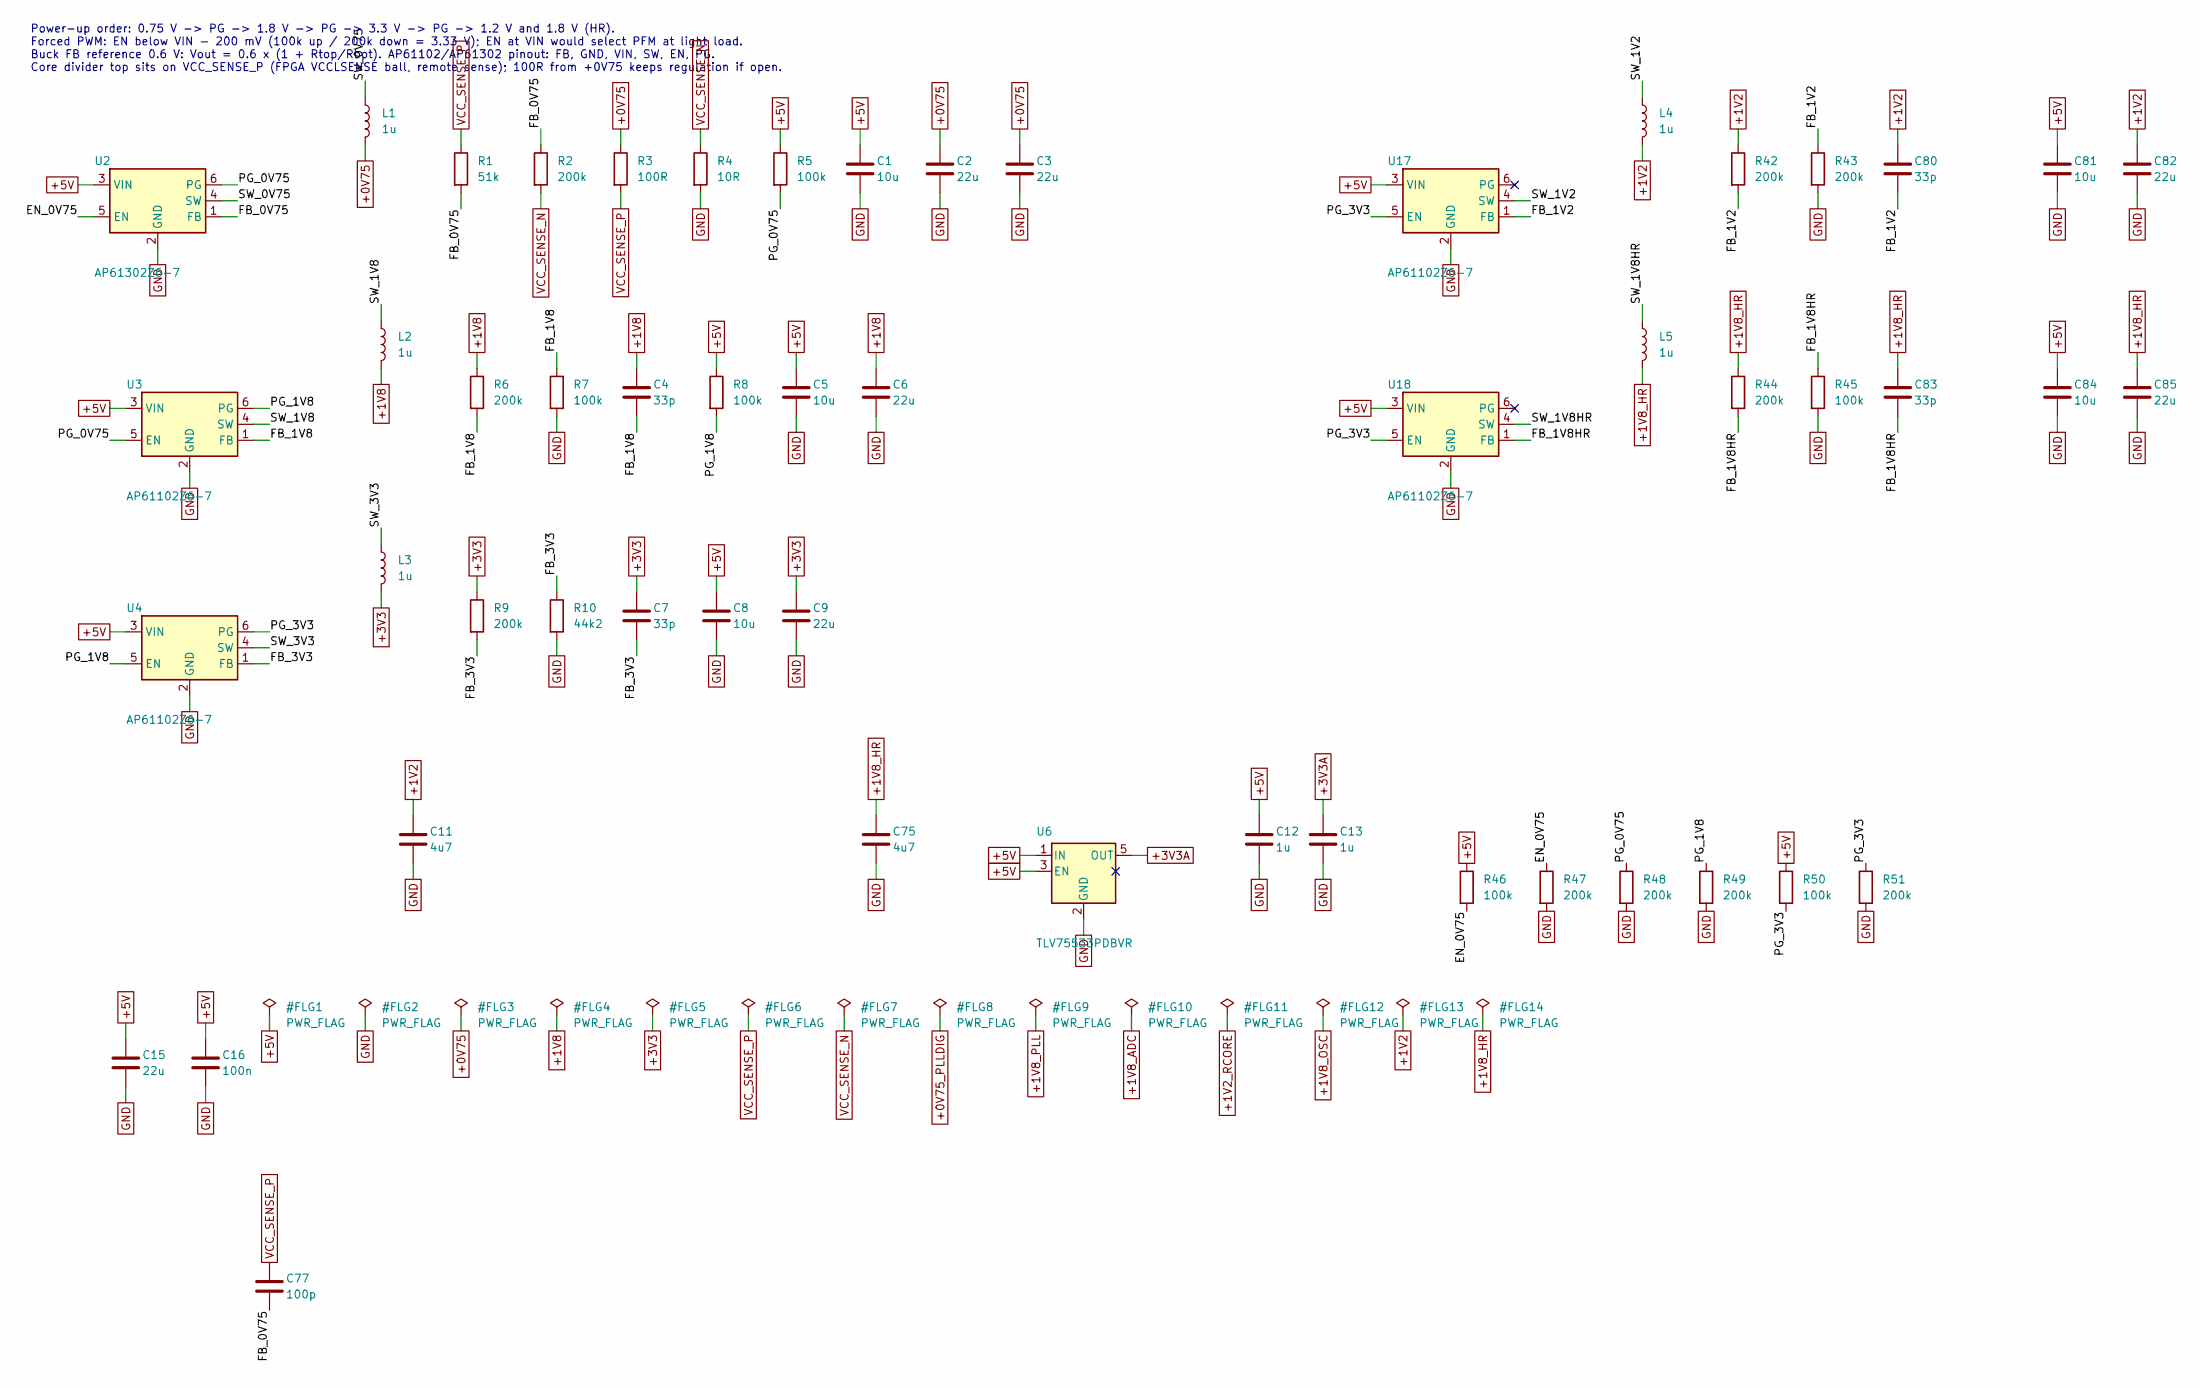
[picture p9: schematic power.kicad_sch, Power: 5 V in, 0.75/1.8/3.3/1.2/1.8 V (HR) bucks, analog 3.…]

Parts:
C1, C5, C8, C81, C84: 10u; C_0603_1608Metric; MPN CL10A106KP8NNNC; LCSC C19702
C2, C3, C6, C9, C82, C85: 22u; C_0603_1608Metric; MPN CL10A226MQ8NRNC; LCSC C59461
C4, C7, C80, C83: 33p; C_0402_1005Metric; MPN 0402CG330J500NT; LCSC C1562
C11, C75: 4u7; C_0603_1608Metric; MPN CL10A475KO8NNNC; LCSC C19666
C12, C13: 1u; C_0402_1005Metric; MPN CL05A105KA5NQNC; LCSC C52923
C15: 22u; C_0805_2012Metric; MPN CL21A226MAQNNNE; LCSC C45783
C16: 100n; C_0402_1005Metric; MPN CL05B104KO5NNNC; LCSC C1525
C77: 100p; C_0402_1005Metric; MPN 0402CG101J500NT; LCSC C1546
L1, L2, L3, L4, L5: 1u; L_Cenker_CKCS201610; MPN WPN201610H1R0MT; LCSC C97002
R1: 51k; R_0402_1005Metric; MPN 0402WGF5102TCE; LCSC C25794
R2, R6, R9, R42, R43, R44, R47, R48, R49, R51: 200k; R_0402_1005Metric; MPN 0402WGF2003TCE; LCSC C25764
R3: 100R; R_0402_1005Metric; MPN 0402WGF1000TCE; LCSC C25076
R4: 10R; R_0402_1005Metric; MPN 0402WGF100JTCE; LCSC C25077
R5, R7, R8, R45, R50: 100k; R_0402_1005Metric; MPN 0402WGF1003TCE; LCSC C25741
R10: 44k2; R_0402_1005Metric; MPN 0402WGF4422TCE; LCSC C25895
R46: 100k; R_0201_0603Metric; MPN RC0201FR-07100KL; LCSC C106224
U2: AP61302Z6-7; SOT-563; MPN AP61302Z6-7; LCSC C3193204
U3, U4, U17, U18: AP61102Z6-7; SOT-563; MPN AP61102Z6-7; LCSC C5224055
U6: TLV75533PDBVR; SOT-23-5; MPN TLV75533PDBVR; LCSC C404027

Connections:
+0V75: C2.1, C3.1, L1.2, R3.1; also elsewhere on the board
+1V2: C11.1, C80.1, C82.1, L4.2, R42.1; also elsewhere on the board
+1V8: C4.1, C6.1, L2.2, R6.1; also elsewhere on the board
+1V8_HR: C75.1, C83.1, C85.1, L5.2, R44.1; also elsewhere on the board
+3V3: C7.1, C9.1, L3.2, R9.1; also elsewhere on the board
+3V3A: C13.1, U6.5 (OUT); also elsewhere on the board
+5V: C1.1, C5.1, C8.1, C12.1, C15.1, C16.1, C81.1, C84.1, R5.1, R8.1, R46.1, R50.1, U2.3 (VIN), U3.3 (VIN), U4.3 (VIN), U6.1 (IN), U6.3 (EN), U17.3 (VIN), U18.3 (VIN); also elsewhere on the board
/Power/EN_0V75: R46.2, R47.1, U2.5 (EN)
/Power/FB_0V75: C77.2, R1.2, R2.1, U2.1 (FB)
/Power/FB_1V2: C80.2, R42.2, R43.1, U17.1 (FB)
/Power/FB_1V8: C4.2, R6.2, R7.1, U3.1 (FB)
/Power/FB_1V8HR: C83.2, R44.2, R45.1, U18.1 (FB)
/Power/FB_3V3: C7.2, R9.2, R10.1, U4.1 (FB)
/Power/PG_0V75: R5.2, R48.1, U2.6 (PG), U3.5 (EN)
/Power/PG_1V8: R8.2, R49.1, U3.6 (PG), U4.5 (EN)
/Power/PG_3V3: R50.2, R51.1, U4.6 (PG), U17.5 (EN), U18.5 (EN)
/Power/SW_0V75: L1.1, U2.4 (SW)
/Power/SW_1V2: L4.1, U17.4 (SW)
/Power/SW_1V8: L2.1, U3.4 (SW)
/Power/SW_1V8HR: L5.1, U18.4 (SW)
/Power/SW_3V3: L3.1, U4.4 (SW)
GND: C1.2, C2.2, C3.2, C5.2, C6.2, C8.2, C9.2, C11.2, C12.2, C13.2, C15.2, C16.2, C75.2, C81.2, C82.2, C84.2, C85.2, R4.2, R7.2, R10.2, R43.2, R45.2, R47.2, R48.2, R49.2, R51.2, U2.2 (GND), U3.2 (GND), U4.2 (GND), U6.2 (GND), U17.2 (GND), U18.2 (GND); also elsewhere on the board
VCC_SENSE_N: R2.2, R4.1; also elsewhere on the board
VCC_SENSE_P: C77.1, R1.1, R3.2; also elsewhere on the board

Notes on the sheet:
Power-up order: 0.75 V -> PG -> 1.8 V -> PG -> 3.3 V -> PG -> 1.2 V and 1.8 V (HR). Forced PWM: EN below VIN - 200 mV (100k up / 200k down = 3.33 V); EN at VIN would select PFM at light load. Buck FB reference 0.6 V: Vout = 0.6 x (1 + Rtop/Rbot). AP61102/AP61302 pinout: FB, GND, VIN, SW, EN, PG. Co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

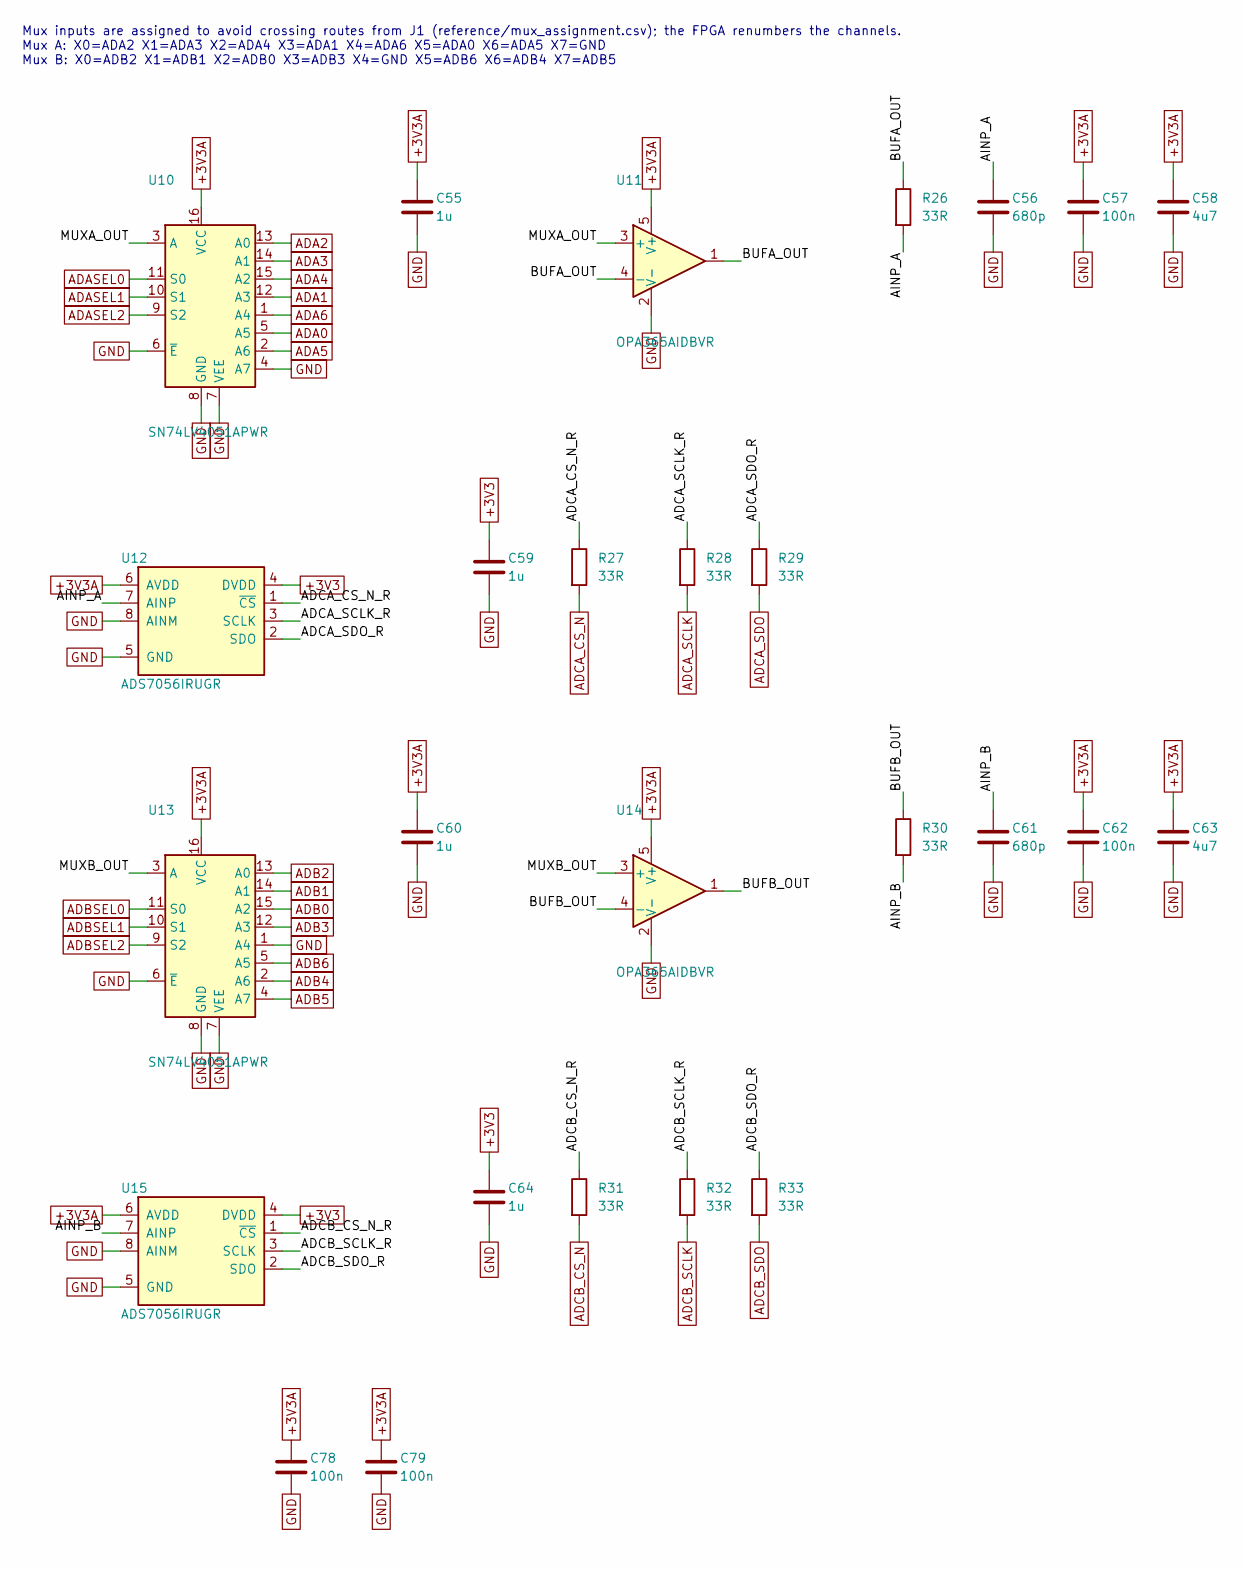
[picture p10: schematic adc.kicad_sch, Two 8:1 mux -> buffer -> ADS7056 chains (0..3.3 V)]

Parts:
C55, C59, C60, C64: 1u; C_0402_1005Metric; MPN CL05A105KA5NQNC; LCSC C52923
C56, C61: 680p; C_0402_1005Metric; MPN CC0402JRNPO9BN681; LCSC C113781
C57, C62, C78, C79: 100n; C_0402_1005Metric; MPN CL05B104KO5NNNC; LCSC C1525
C58, C63: 4u7; C_0603_1608Metric; MPN CL10A475KO8NNNC; LCSC C19666
R26, R30: 33R; R_0402_1005Metric; MPN 0402WGF330JTCE; LCSC C25105
R27, R28, R29, R32, R33: 33R; R_0201_0603Metric; MPN RC-01W33R0FT; LCSC C320843
R31: 33R; C_0201_0603Metric; MPN RC-01W33R0FT; LCSC C320843
U10, U13: SN74LV4051APWR; TSSOP-16_4.4x5mm_P0.65mm; MPN SN74LV4051APWR; LCSC C7793
U11, U14: OPA365AIDBVR; SOT-23-5; MPN OPA365AIDBVR; LCSC C96626
U12, U15: ADS7056IRUGR; Texas_UQFN-8_1.5x1.5mm_P0.5mm; MPN ADS7056IRUGR; LCSC C2669798

Connections:
+3V3: C59.1, C64.1, U12.4 (DVDD), U15.4 (DVDD); also elsewhere on the board
+3V3A: C55.1, C57.1, C58.1, C60.1, C62.1, C63.1, C78.1, C79.1, U10.16 (VCC), U11.5 (V+), U12.6 (AVDD), U13.16 (VCC), U14.5 (V+), U15.6 (AVDD); also elsewhere on the board
/ADC/ADCA_CS_N_R: R27.1, U12.1 (~CS)
/ADC/ADCA_SCLK_R: R28.1, U12.3 (SCLK)
/ADC/ADCA_SDO_R: R29.1, U12.2 (SDO)
/ADC/ADCB_CS_N_R: R31.1, U15.1 (~CS)
/ADC/ADCB_SCLK_R: R32.1, U15.3 (SCLK)
/ADC/ADCB_SDO_R: R33.1, U15.2 (SDO)
/ADC/AINP_A: C56.1, R26.2, U12.7 (AINP)
/ADC/AINP_B: C61.1, R30.2, U15.7 (AINP)
/ADC/BUFA_OUT: R26.1, U11.1, U11.4 (-)
/ADC/BUFB_OUT: R30.1, U14.1, U14.4 (-)
/ADC/MUXA_OUT: U10.3 (A), U11.3 (+)
/ADC/MUXB_OUT: U13.3 (A), U14.3 (+)
ADA0: U10.5 (A5); also elsewhere on the board
ADA1: U10.12 (A3); also elsewhere on the board
ADA2: U10.13 (A0); also elsewhere on the board
ADA3: U10.14 (A1); also elsewhere on the board
ADA4: U10.15 (A2); also elsewhere on the board
ADA5: U10.2 (A6); also elsewhere on the board
ADA6: U10.1 (A4); also elsewhere on the board
ADASEL0: U10.11 (S0); also elsewhere on the board
ADASEL1: U10.10 (S1); also elsewhere on the board
ADASEL2: U10.9 (S2); also elsewhere on the board
ADB0: U13.15 (A2); also elsewhere on the board
ADB1: U13.14 (A1); also elsewhere on the board
ADB2: U13.13 (A0); also elsewhere on the board
ADB3: U13.12 (A3); also elsewhere on the board
ADB4: U13.2 (A6); also elsewhere on the board
ADB5: U13.4 (A7); also elsewhere on the board
ADB6: U13.5 (A5); also elsewhere on the board
ADBSEL0: U13.11 (S0); also elsewhere on the board
ADBSEL1: U13.10 (S1); also elsewhere on the board
ADBSEL2: U13.9 (S2); also elsewhere on the board
ADCA_CS_N: R27.2; also elsewhere on the board
ADCA_SCLK: R28.2; also elsewhere on the board
ADCA_SDO: R29.2; also elsewhere on the board
ADCB_CS_N: R31.2; also elsewhere on the board
ADCB_SCLK: R32.2; also elsewhere on the board
ADCB_SDO: R33.2; also elsewhere on the board
GND: C55.2, C56.2, C57.2, C58.2, C59.2, C60.2, C61.2, C62.2, C63.2, C64.2, C78.2, C79.2, U10.4 (A7), U10.6 (~E), U10.7 (VEE), U10.8 (GND), U11.2 (V-), U12.5 (GND), U12.8 (AINM), U13.1 (A4), U13.6 (~E), U13.7 (VEE), U13.8 (GND), U14.2 (V-), U15.5 (GND), U15.8 (AINM); also elsewhere on the board

Notes on the sheet:
Mux inputs are assigned to avoid crossing routes from J1 (reference/mux_assignment.csv); the FPGA renumbers the channels. Mux A: X0=ADA2 X1=ADA3 X2=ADA4 X3=ADA1 X4=ADA6 X5=ADA0 X6=ADA5 X7=GND Mux B: X0=ADB2 X1=ADB1 X2=ADB0 X3=ADB3 X4=GND X5=ADB6 X6=ADB4 X7=ADB5

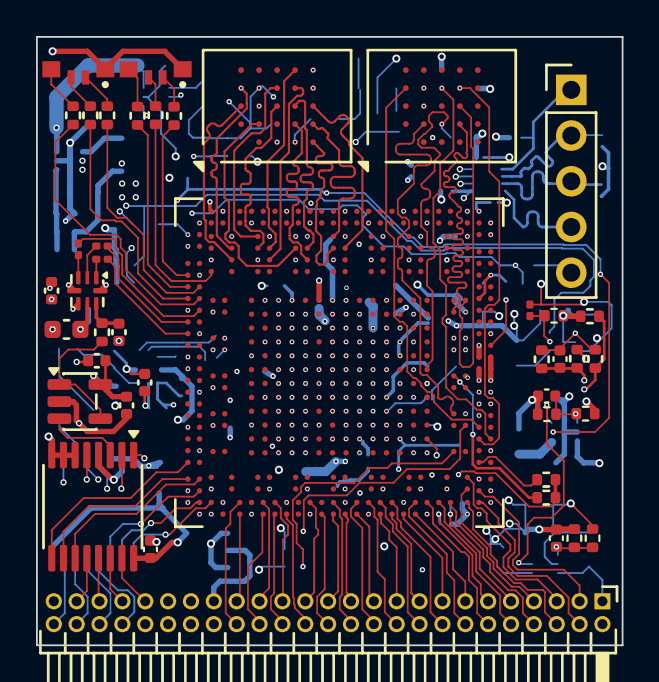
[picture p11: board control_card.kicad_pcb from above]

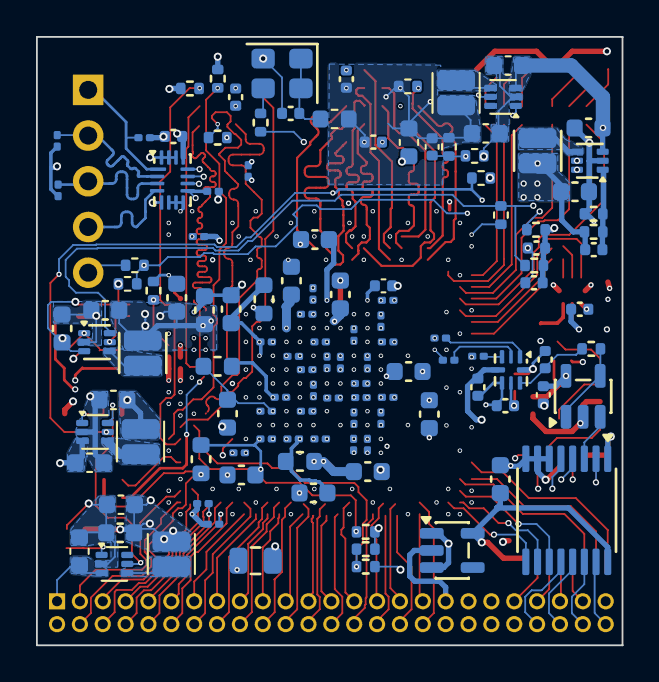
[picture p12: board control_card.kicad_pcb from below]

Board: 6 copper layers, 32.5 x 33.8 mm, 164 parts (122 on the bottom side), 145 nets.
