johonkanen/agilex3_control_card/(commit log)

2026-10-19 Agilex 3 control card: KiCad 10 schematic, 6-layer board, generator tools and docs
    [A3CY025B_pin_list_B18A.csv, A3CZ065B_pin_list_B18A.csv, adc.kicad_sch, agilex3_card_v1_fpga_balls.csv, altera-pbc-b18a-a5e-a3c-1p1.csv, bom_draft.csv, config.kicad_sch, connector.kicad_sch]
2026-10-19 Add README with board renders
2026-10-19 Remove dangling track stubs; No-Connect flag from B3 to C2
    - Deleted the 6 dangling stubs DRC reported and the dead-end branches behind
    them: an unused PG_0V75 route on L4 at U3, an abandoned PG_1V8 route on
    B.Cu (83.1, 111.3) to (90.75, 104.14), and short stubs on CUK_CS, +1V8,
    HR_DQ7 and +1V2_RCORE. DRC stayed at 0 unconnected after each deletion.
    - fpga_io: the No-Connect flag on U1 B3 (now HR_RESET_N) moved to the unused C2.
    DRC: 0 errors, 0 unconnected, 0 parity issues; silkscreen warnings only.
    ERC: only GNDSENSE on VCC_SENSE_N (intended).
    [control_card.kicad_pcb, fpga_io.kicad_sch]
2026-10-19 Silkscreen: text 0.8 x 0.7 mm, lines 0.15 mm
    - All 144 visible silkscreen texts set to 0.8 mm high, 0.7 mm wide, 0.15 mm
    stroke (were 1.0 x 1.0 mm; U1, D1, D2 1.27 mm), the smallest that still
    prints legibly at JLCPCB.
    - Footprint outlines on silkscreen widened from 0.12 to 0.15 mm, JLC's minimum
    line width.
    - Board defaults for new silkscreen text and lines set to match.
    DRC: 0 errors, 0 unconnected, 0 parity issues; 335 silkscreen warnings (were 433).
    [control_card.kicad_pcb]
2026-10-19 Hide silkscreen reference designators
    The dense two-sided layout leaves no room for readable reference text, so
    all 144 footprint texts on silkscreen are hidden. Outlines and pin-1 marks
    stay for assembly and rotation checks; JLC places parts from the CPL file.
    DRC: 0 errors, 0 unconnected, 0 parity issues; 29 silkscreen warnings
    (outlines at the board edge and 3 small outline overlaps).
    [control_card.kicad_pcb]
2026-10-19 0.75 V buck: bottom-layer +0V75, GND and SW_0V75 zones
    - B.Cu zones at the core buck: +0V75 over C3.1, C2.1 and L1.2; GND over
    C3.2/C2.2 and their vias; SW_0V75 from L1.1 to U2.4, kept narrow. Priority 5,
    0.2 mm clearance, solid pad connection, as at the 1.8 V buck.
    - Includes hand edits made in KiCad since ffc3a6f.
    DRC: 0 errors, 0 unconnected, 0 parity issues; 30 silkscreen warnings.
    [control_card.kicad_pcb]
2026-10-19 33 ohm series resistors on 0201 pads: order the 0201 part
    R27-R29 and R31-R33 sit on 0201 footprints but still carried the 0402
    0402WGF330JTCE (C25105), so JLC would have placed 0402 parts on 0201 pads.
    LCSC and MPN set to RC-01W33R0FT (C320843, 0201, 33 ohm 1 %) in the schematic
    and on the board. Every other BOM line's footprint matches its JLC package.
    DRC: 0 errors, 0 unconnected, 0 parity issues.
    [adc.kicad_sch, control_card.kicad_pcb]
2026-10-19 R1 (core buck feedback 49.9k): Yageo RC0402FR-0749K9L
    The UniOhm 0402WGF4992TCE (C25897) showed 831 in stock but -38942 orderable
    at JLC (oversold) with a 9023-piece minimum. Replaced by RC0402FR-0749K9L
    (C137969, 0402 49.9k 1 %, 1.28M orderable, no minimum) in the schematic and
    on the board. Core voltage unchanged.
    Every part in the final BOM now has orderable stock for 10 boards and a
    minimum purchase of 1; tightest is ADS7056 (34 orderable, 2 per board).
    [control_card.kicad_pcb, power.kicad_sch]
2026-10-21 start doing route cleanup
    [control_card.kicad_pcb]
2026-10-22 jlc_bom_cpl: JLC rotation conventions in the CPL
    - Bottom-side parts as seen from below: KiCad angle a becomes 180 - a.
    - Package offsets from the kicad-jlcpcb-tools / JLCKicadTools table
    (SOT-23 +180, TSSOP/SOIC/SOP/QFN/DFN +270, ...), added on top and
    subtracted on the bottom.
    - Footprint field "JLC Rotation Offset" overrides the table per part.
    - Prints the parts that got an offset.
2026-10-22 HyperRAM to bank 6D; BGA via-in-pads 0.25/0.15; Default via 0.3/0.15
    - Schematic: the 12 HyperRAM signals moved from bank 6C to 6D for easier
    length matching: HR_CK F18 (SOURCE_SYNC_CLK1), CS_N H7, RWDS F10,
    RESET_N F7, DQ0-7 F21 H21 D10 H13 F13 F27 D26 F26. 6D is 1.8 V on
    +1V8_HR and keeps CLK100M on D18; 6C is now unused (No-Connect flags).
    pin_assignment.csv / io_assignment.csv regenerated; docs updated.
    - Board: PCB updated from the schematic (HyperRAM reroute in progress);
    ten oversized 0.35/0.2 vias in BGA/0201 pads (incl. U1 D7) reset to
    0.25/0.15 so tracks fit between the balls.
    - Default net class via 0.35/0.2 -> 0.3/0.15.
    DRC: no clearance errors; 8 unconnected and 9 d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
    [control_card.kicad_pcb, fpga_io.kicad_sch, io_assignment.csv, pin_assignment.csv]
2026-10-22 route hyperram to bank d for easier length matching
    [control_card.kicad_pcb]
2026-10-22 HyperRAM length rule 10.8 mm; HyperRAM routed to bank 6D
    - control_card.kicad_dru: rule "hyperram_length" matches every HR_* net
    except HR_CK (phase-shifted by the controller) to 10.8 mm, DRC window
    10.7-10.9 mm. Only HR_DQ4 (10.77 mm) is in range so far; the others need
    length added with the tuning tool.
    - Board: HyperRAM routing to the 6D balls (hand routing), 0 unconnected.
    [control_card.kicad_pcb]
2026-10-22 HyperRAM length-matched to 10.8 mm
    All eleven matched HR_* nets measure 10.80-10.85 mm, all on F.Cu, within the
    10.7-10.9 mm rule; HR_CK (excluded) is 12.88 mm. DRC: 0 errors, 0 unconnected,
    0 parity issues; one dangling 0.33 mm PG_1V8 stub on B.Cu at (90.75, 104.14).
    [control_card.kicad_pcb]
2026-10-22 Remove dangling PG_1V8 stub
    0.33 mm B.Cu stub at (90.75, 104.14). DRC: 0 errors, 0 unconnected, no
    dangling items, 0 parity issues; 30 silkscreen warnings only.
    [control_card.kicad_pcb]
2026-10-22 docs: bring-up and JLCPCB production checklists
    - bringup_checklist.md: verifying assembled boards from a clean start:
    rail table with probe points and expected voltages, pin-1 table for the
    19 polarized parts, resistance checks, current-limited first power-up and
    sequence, clock, JTAG, first design and Quartus pin setup, flash boot,
    HyperRAM, ADCs, J1 interface, load/temperature, result log.
    - jlcpcb_production_checklist.md: verifying the KiCad project and order
    files against JLC's current capabilities: ERC/DRC expectations, board
    figures vs capability limits, Gerber/drill contents, BOM package and
    orderable-stock checks, CPL rotations and preview, order-form settings,
    accep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
2026-10-22 Replace two capacitors oversold at JLC
    - C21-C23, C30, C31, C45 (4.7uF 0201 6.3V X5R): GRM035R60J475ME15D
    (C335103, -6875 orderable, min 127) -> Taiyo Yuden JDK063BBJ475MV-AT
    (C2880368, 109712 orderable, min 1).
    - C65, C67, C69, C71 (47uF 0603 6.3V X5R): CGA0603X5R476M6R3JT
    (C6119831, -979 orderable, min 97) -> Murata GRM188R60J476ME15D
    (C140782, 124695 orderable, min 1).
    Schematic and board updated together. All BOM parts now orderable for 10
    boards with min purchase 1; tightest ADS7056 (29 orderable, 2 per board).
    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
    [control_card.kicad_pcb, fpga_power.kicad_sch]
2026-10-22 J1 pads 0.9 mm: annular ring 0.17 mm (JLC minimum 0.15)
    J1's 50 pads were U25's 0.8128 mm on 0.5588 mm drills, a 0.127 mm annular
    ring, below JLC's multilayer minimum of 0.15 mm (production-checklist
    review). Pads enlarged to 0.9 mm in the footprint and on the board; drills
    unchanged. Tracks between the pins still clear: closest pad-to-track
    0.109 mm, hole-to-copper 0.28 mm. DRC: 0 errors, 0 unconnected, 0 parity.
    [control_card.kicad_pcb]
2026-10-22 Design-review fixes: core buck feed-forward, EPWM2A/B pull-downs, mux bypass
    From the pre-order design review:
    - C77 120 pF C0G (C40059) across R1, VCC_SENSE_P to FB_0V75: the AP61302
    datasheet requires a feed-forward cap (33 pF with a 200k top resistor;
    scaled for R1 = 49.9k).
    - C4, C7 22 pF -> 33 pF (C1562), the AP61102 datasheet value for these
    dividers.
    - R40, R41 10k 0201 pull-downs on EPWM2A / EPWM2B. These drive the power
    board's Si8661 isolator inputs, which have no pull-down there; the other
    PWM lines already have 10k pull-downs on the power board.
    - C78, C79 100 nF extra +3V3A bypass for the muxes (C79 is placed near U14;
    move it to U13 pin 16 if it's meant for U13).
    Pa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
    [adc.kicad_sch, connector.kicad_sch, control_card.kicad_pcb, power.kicad_sch]
2026-10-22 BOM: secure 680p stock, two extended parts to basic
    - C56, C61 (680 pF C0G kickback): 0402CG681J500NT (C301953, 78 orderable)
    -> Yageo CC0402JRNPO9BN681 (C113781, 57063 orderable), same spec.
    - C77 core feed-forward 120 pF (C40059, extended) -> 100 pF C0G basic
    (C1546); zero moves from 24 to 31 kHz.
    - R1 core divider top 49.9k (C137969, extended) -> 51k basic (C25794);
    core output 0.750 -> 0.753 V (+0.4 %, FPGA allows +/-3 %).
    Extended part types 25 -> 23. Schematic and board updated together;
    docs updated for 51k/0.753 V. Five symbols added earlier re-indented.
    DRC: 0 errors, 0 unconnected, 0 parity issues. ERC: GNDSENSE only.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
    [adc.kicad_sch, connector.kicad_sch, control_card.kicad_pcb, power.kicad_sch]
2026-10-22 Stackup JLC06161H-3313; docs and board renders for the order
    - Board stackup set to JLC06161H-3313 (3313 0.0994 / core 0.55 /
    2116 0.1088 mm), the JLC code to select when ordering. Copper unchanged;
    DRC 0 errors, 0 unconnected, 0 parity.
    - docs/img renders regenerated from the final board.
    - README: status ready to order, current features, checklists, Global
    Sourcing and stock notes.
    - Production checklist: current counts (146 parts, 44 BOM lines, 23
    extended, 270 vias in pads), stock, Global Sourcing workflow, accepted
    deviations. Bring-up checklist: 51k/C77 core divider, PRI_DHB mapping
    question, PWM pull-downs. Design notes: hand-routing and pre-order
    changes, open items. or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
    [control_card.kicad_pcb]
2026-10-23 remove ldos and replace with switchers
    [adc.kicad_sch, connector.kicad_sch, control_card.kicad_pcb, fpga_io.kicad_sch, power.kicad_sch]
2026-10-23 finish placing components
    [control_card.kicad_pcb, power.kicad_sch]
2026-10-28 Switcher pours, GND to U2/U17/U18 pins, R46 0201 part
    B.Cu zones for the SW, output, GND and +5V nodes of all four AP61x02 cells,
    with distinct priorities (equal-priority overlaps hang the KiCad 10 filler).
    Ground pours extended to the switcher GND pins. Removed a dangling GND stub,
    a PG_0V75 via in U2's pad and a dangling +1V2 via; reference designators
    hidden again. R46 sits on an 0201 footprint: part changed to 0201WMF1003TEE
    (C270364). DRC: 0 errors, 0 unconnected, 0 parity issues.
    [control_card.kicad_pcb, power.kicad_sch]
2026-10-28 Move the JLC scripts to the jlc-tools submodule
    tools/jlc is https://github.com/johonkanen/jlc-tools: part search, BOM stock
    check (canPresaleNumber/minPurchaseNum), BOM/CPL and Gerber export.
    tools/fab_outputs.sh is now a wrapper; it produces identical files.
2026-10-28 Docs for the switcher-only power revision
    Bring-up rail table, PG/EN levels at 3.33 V, forced-PWM checks, pin-1
    table recomputed (U4 now bottom, U17/U18 added, U5/U16 removed); design
    notes section on the change; README power bullet and part counts; checklist
    counts 161 parts, 43 lines, 40 top / 121 bottom; plan status.
2026-10-28 R46: RC0201FR-07100KL (C106224)
    0201WMF1003TEE (C270364) went oversold: -58871 orderable, minimum
    purchase 10026. Same value, size and tolerance.
    [control_card.kicad_pcb, power.kicad_sch]
2026-10-29 Board plots via kicad-board-plots: copper layers on the renders branch, table in README
